jbregnard/vesta/README.md

# vesta
Software and hardware files for the Vesta project
