jbregnard/vesta/vesta_pcb_files/readme.md

Here can be found all the files related to the PCB.
