jbregnard/vesta/Rapports/vesta_latex_repport/chap/design.tex

\section{Industrial design}

In this section, the industrial design will presented. The design part was done by the ECAL student. The indutrial designer presented different solutions, they were then discussed together with the other member of the group. The solutions were also presented to the nurses and some old people to define which one is the more understandable and easy to use.

\subsection{Tablet}
The device has a unique aspect. It has round shapes and is elegant.
The color of the case is warm and positive. It also is a visible color and not agressive. The screen size is 7 inches with a resolution of 800x480. It is big enough to display readable messages and images.

The case has a certain thickness to allow the users to have a better grip. The device can have 2 postures, vertical or horizontal. The user can then watch the tablet sitting down and holding it in his hands or the device can be used like a digital photo frame.
When the device is on the charging station it is in the vertical position.

The design of the tablet is shown in the figure \ref{fig:vesta design}.

\begin{figure}[!htb]
    \centering
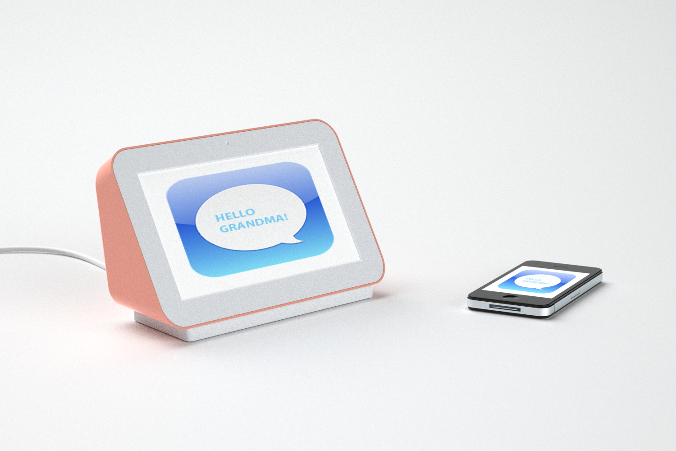
[picture p1: Rapports/vesta_latex_repport/chap/designFig/VestaRender4.png]
    
    \caption{Vesta tablet design}
    \label{fig:vesta design}
\end{figure}

On the left, the vesta tablet on the charging station. On the right, an iphone for scale.

\subsection{Charging station}
The charging station is quite descrete, takes up little space and is very nice. It can be placed anywher without having to hide it.It is wireless. More and more devices in the market allow to charge the battery wirelessly. To charge the tablet's battery, the tablet need to be located on the charging station. The advantage of this station is that the users don't need to plug a small cable like micro USB into the tablet to charge it. The charging station method is much easier to use.

\begin{sidewaysfigure}[!htb]
    \centering
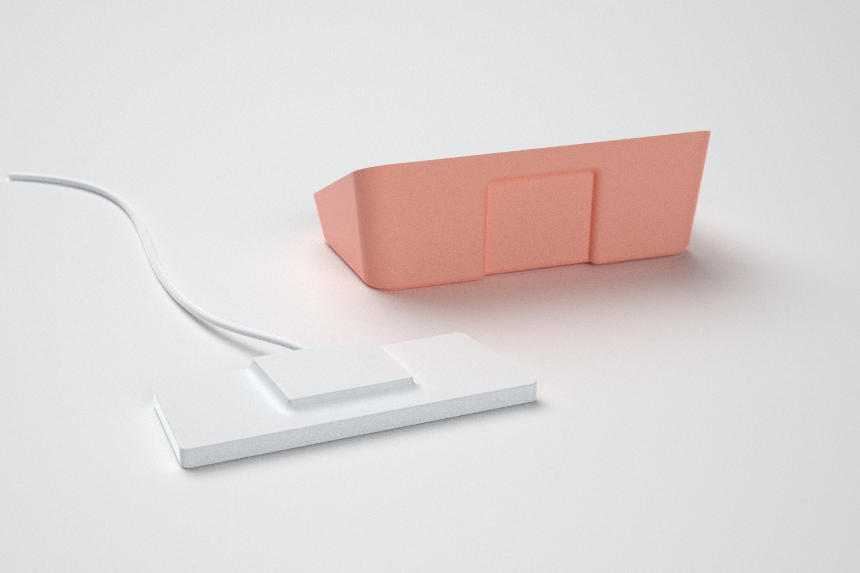
[picture p2: Rapports/vesta_latex_repport/chap/designFig/VisioRender7.png]
    
    \caption{Charging station}
    \label{fig:charging station}
\end{sidewaysfigure}

On the left, the inductive charging station. On the right, the vesta tablet in horizontal position.

\clearpage

\subsection{Software design}

The software located on the tablet needs to be very easy to use and understandable by an old person. Different designs were imagined, tested and compared.

The graphical interface of the software is shown in the figure \ref{fig:soft design}.

\begin{figure}[!htb]
    \centering
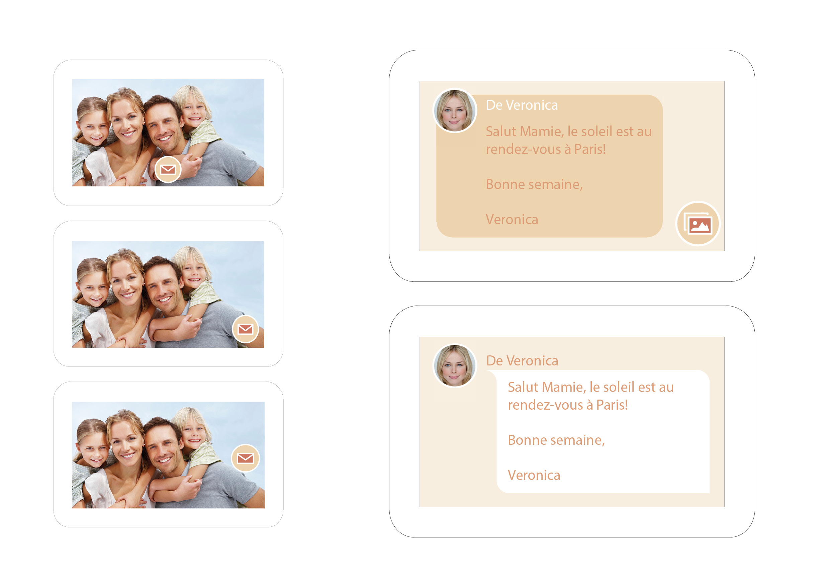
[picture p3: Rapports/vesta_latex_repport/chap/designFig/vesta_design.jpg]
    
    \caption{Software design}
    \label{fig:soft design}
\end{figure}

On the left the software design imagined for the picture display with the button to display the text message. And on the right, the design of the text message display with the picture of the sender and the button to return to the picture.
\subsection{Visual identity}
The visual identity keeps the same tone of colours as the casing of the device. A name a logo and a style were sought for.

In figure \ref{fig:id seek} different logos can be seen.
\begin{figure}[!htb]
    \centering
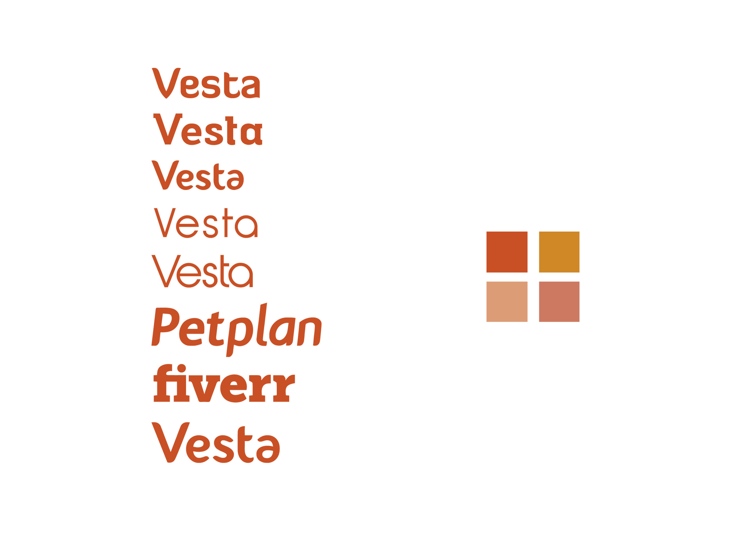
[picture p4: Rapports/vesta_latex_repport/chap/designFig/VestaRechercheIdentity3.jpg]
    
    \caption{Search for a visual identity}
    \label{fig:id seek}
\end{figure}

In figure \ref{fig:id seek icon} different icons where imagined and evaluated.

\begin{figure}[!htb]
    \centering
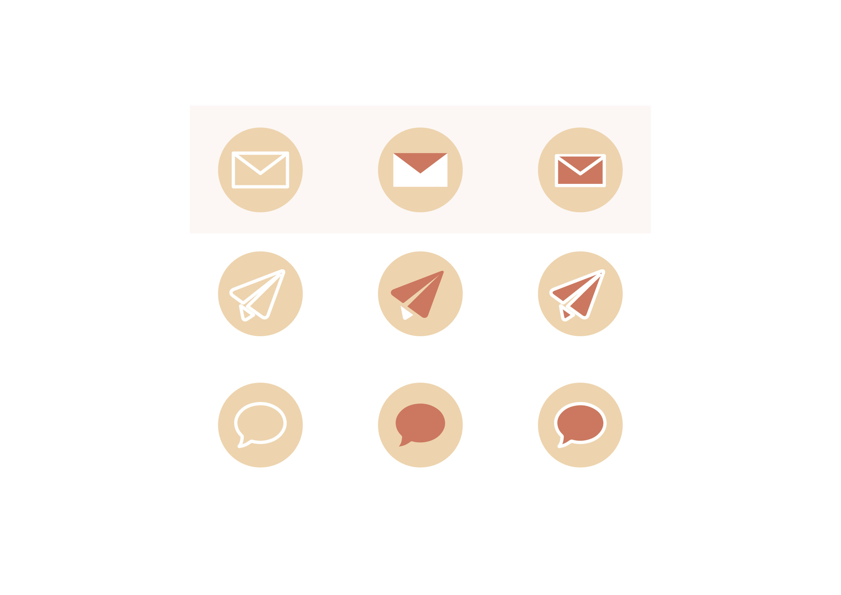
[picture p5: Rapports/vesta_latex_repport/chap/designFig/VestaRechercheIdentity5.jpg]
    
    \caption{Search for a visual identity specific to icons}
    \label{fig:id seek icon}
\end{figure}
