jbregnard/vesta/Rapports/vesta_latex_repport/chap/software.tex

\definecolor{gray}{rgb}{0.4,0.4,0.4}
\definecolor{darkblue}{rgb}{0.0,0.0,0.6}
\definecolor{cyan}{rgb}{0.0,0.6,0.6}

\section{Software}
%\subsection{Description}
The software of this project contains 3 parts:
\begin{itemize}
\item{The operating system configuration and modification to be fully compatible with the hardware used.}
\item{The website that is used by the young users to send pictures and messages to the old users.}
\item{The Vesta tab software that is used on the tablet to display the differents messages and pictures received by the old users.}
\end{itemize}

The concept of this software is easy to understand. Every tablet has a unique id like a phone number. The young user knows this id and can send messages and pictures to the wanted tablet through the website. The tablet just needs to be configured to connect to the wifi and get messages sent by the young user. The old person has almost nothing to do, the pictures are displayed automatically. He can naviguate in the old messages by swiping the pictures on the tablet.

It is similar to a digital photo frame but the pictures are not put on the tablet by the tablet owner but by the young user.

The figure \ref{fig:web connections} shows the web interactions between the website and the Vesta software on the tablet.

\begin{figure}[!htb]
    \centering
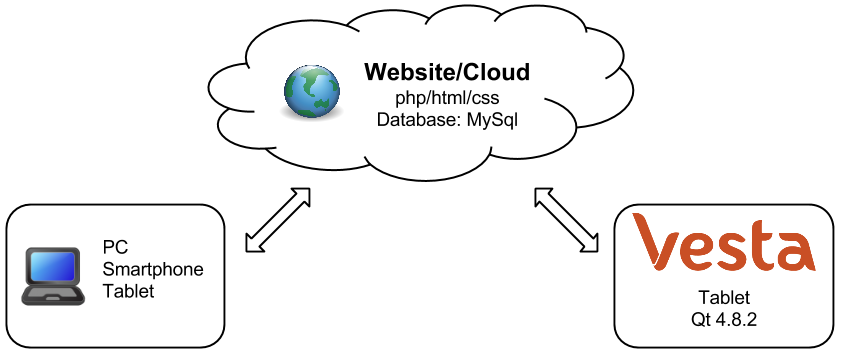
[picture p27: Rapports/vesta_latex_repport/chap/softFig/web_connections.png]
    
    \caption{Web connections}
    \label{fig:web connections}
\end{figure}

\clearpage

The figure \ref{fig:user flow} shows the interactions between the website and the Vesta software on the tablet. All the files are stored on the website on the mySQL database. When the pictures are sent, the vesta tablet receives a message and can open/display it. The vesta software on the tablet works on a linux OS that manages the hardware.

\begin{figure}[!htb]
    \centering
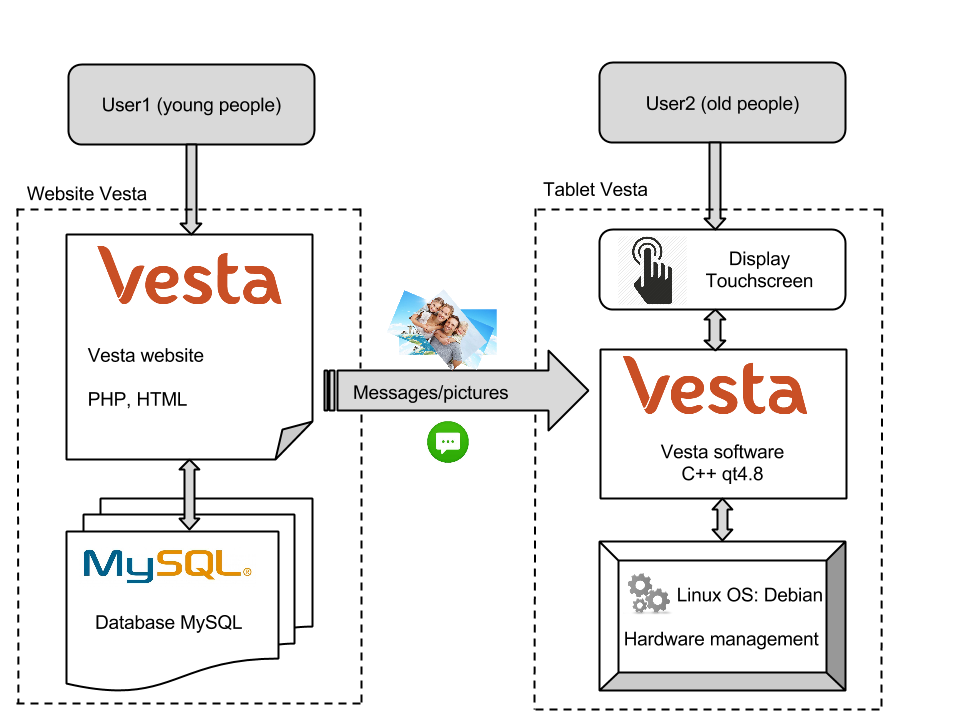
[picture p28: Rapports/vesta_latex_repport/chap/softFig/block_diagram_vesta2.png]
    
    \caption{Basic user flow.}
    \label{fig:user flow}
\end{figure}

\clearpage

\subsection{Operating system}
The OS used for this project is a debian. Debian is a linux distribution and was given by the conceptors of the beaglebone black.

The original OS is available on the beaglebone black developer website: http://beagleboard.org/latest-images

The figure \ref{fig:OS} shows how the are the interactions between the OS and the hardware or the software.

\begin{figure}[!htb]
    \centering
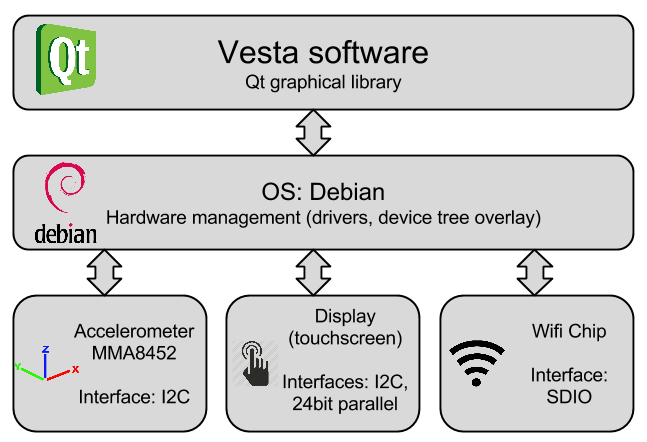
[picture p29: Rapports/vesta_latex_repport/chap/softFig/first_diagram2.png]
    
    \caption{Interactions between the operating system and the hardware/software.}
    \label{fig:OS}
\end{figure}

The original OS contains:
\begin{itemize}
\item{kernel 3.8: The linux kernel (an old one)}
\item{X11: The graphical server}
\item{lxdm: The user session management}
\item{lxde: A desktop (light)}
\end{itemize}

The OS manages the communications with the different hardware. The accelerometer is controled by I2C (to read datas and write configurations). The screen uses different interfaces, I2C for the touch panel and 24bit parallel for the display. The WIFI chip is connected with SDIO and it replaces the emmc memory.

Every protocol and every pins input or output have to be declared in a file called device tree source. In the 3.14 kernel, this file is compiled and becomes a device tree blob. The compiled version of the file is executed at the OS startup. It initiates the loading of the drivers and configures the pins as input, output, pwm or interrupt. Some pins can be configured as i2c, spi, SDIO or some other protocols.

Packets installed on the original debian OS:
\begin{itemize}
\item{libqt4-core: Defaults tools for Qt software execution}
\item{libqt4-gui: Needed to display GUI software developped with Qt}
\item{dtc: Device tree compiler used to create pin configuration at the OS startup}
\item{wicd: Network manager for WIFI connections}
\item{evtest: Tool for interruption event, used especially to debug the touchscreen}
\end{itemize}

\subsubsection{Drivers}
A lot of work on this linux distribution was made to be fully compatible with the chosen hardware.
The touch screen driver edt-ft5x06 had problems with the original 3.8 kernel of the distribution used. The driver was not loading correctly from the device tree overlay. An upgrade to the 3.14 kernel resolved the problem.
Then the scale of the touchscreen was not correct.
When a touch event occured on the right-down corner, the mouse pointer moved to the center of the screen. Some configuration scripts had to be modified for the X11 graphical display server.

The edt-ft5x06 uses an interrupt line and I2C to get the touch events and the positions of the clicks.

Another driver is used for the WIFI connection with the wl1835mod. This driver uses the protocol SDIO. It also has to be declared and initialized at the OS startup in the device tree blob. As the beaglebone's processor has only one SDIO protocol possible and it is used by the emmc memory, the emmc is replaced by the WIFI chip and the emmc is unusable.

An example of the configuration of the I2C1 of the beaglebone black as an entry for the touch panel (driver edt-ft5x06) in the device tree source (dts) is shown in the listing below.

\begin{lstlisting}
i2c@4802a000 {
	compatible = "ti,omap4-i2c";
	ti,hwmods = "i2c2";
	reg = <0x4802a000 0x1000>;
	interrupts = <0x47>;
	status = "okay";
	pinctrl-names = "default";
	pinctrl-0 = <0x29>;
	clock-frequency = <0x61a80>;

	edt-ft5306@38 {
		status = "okay";
		compatible = "edt,edt-ft5306", "edt,edt-ft5x06";
		pinctrl-names = "default";
		pinctrl-0 = <0x2a>;
		reg = <0x38>;
		interrupt-parent = <0x1c0>;
		interrupts = <0x15 0x0>;
		touchscreen-size-x = <0x320>;
		touchscreen-size-y = <0x1e0>;
	};
};
\end{lstlisting}

i2c@4802a000 corresponds to the I2C1 of the beaglebone black (even if it defines I2C2 in ti,hwmods, this is due to a problem in the kernel 3.14 the pins are not named correctly). The following commands init the I2C1 at the clock frequency 0x61a80. The line starting with edt-ft5306@38 declare that the driver edt-ft5x06 has to be link to the I2C1 and the I2C adress is 0x38. Different inputs are declared in the brackets, the interrupt-parent and interrupts defines the interrupt line when a touch event occurs. Reg is the I2C adress of the Focaltech chip (ft5x06). The pin <0x1c0 0x15 0x0> corresponds to the pin 25 of the beaglebone black. The touchscreen size is also given: 800*480 (0x320*0x1e0).

\clearpage

\subsubsection{Display}
The touch screen works with a 24 bits parallel interface so the X11 configuration file had to be modified to work correctly. The LCD output was initialy configured in 16 bits parallel interface.
In the blob file, the driver for the touch panel was declared and the interrupt pins was defined. The resolution and frequency of the display is also configured in this script. The wifi chip also needs to load drivers at startup and tell the OS to connect to internet via this chip and with the SDIO protocol.
The file is located in /boot/dtbs/3.14xx/ and is called vesta.dtb (compiled) and the source is called vesta.dts. The file uEnv.txt located in /boot/ also needs to define which device tree blob(dtb) the OS has to load at startup.

The following listing shows how to define the display output on the pins of the beaglebone black. It is a critical step and need to be declared like this.
\begin{lstlisting}
display-timings {
	native-mode = <0x1c5>;

	800x480 {
		clock-frequency = <0x1c9c380>;
		hactive = <0x320>;
		vactive = <0x1e0>;
		hfront-porch = <0x1>;
		hback-porch = <0x2d>;
		hsync-len = <0x1e>;
		vback-porch = <0x16>;
		vfront-porch = <0xc>;
		vsync-len = <0x2>;
		hsync-active = <0x1>;
		vsync-active = <0x1>;
		de-active = <0x1>;
		pixelclk-active = <0x0>;
		linux,phandle = <0x1c9>;
		phandle = <0x1c9>;
	};
};
\end{lstlisting}

The native-mode defines that it is a 16/9 screen. The clock frequency is 30MHz and the resolution 800x480. hactive and vactive define respectively the horizontal number of active pixel and the vertical number of pixel active (in our case 800x480). Other configuration modes are defined then. For more informations about the configurations, check the Newheaven touchscreen's datasheet.

\clearpage

\subsection{Website}

The website is used by the young users to send messages and pictures to the old user’s tablet.
The website contains a MySQL database, a php/html page that let the young user send a message and a php script used to parse the database to XML to be readable by the tablet.

The figure \ref{fig:web archi} shows the architecture of the interactions between the webpage, the database and the connections by the tablet through a script.

\begin{figure}[!htb]
    \centering
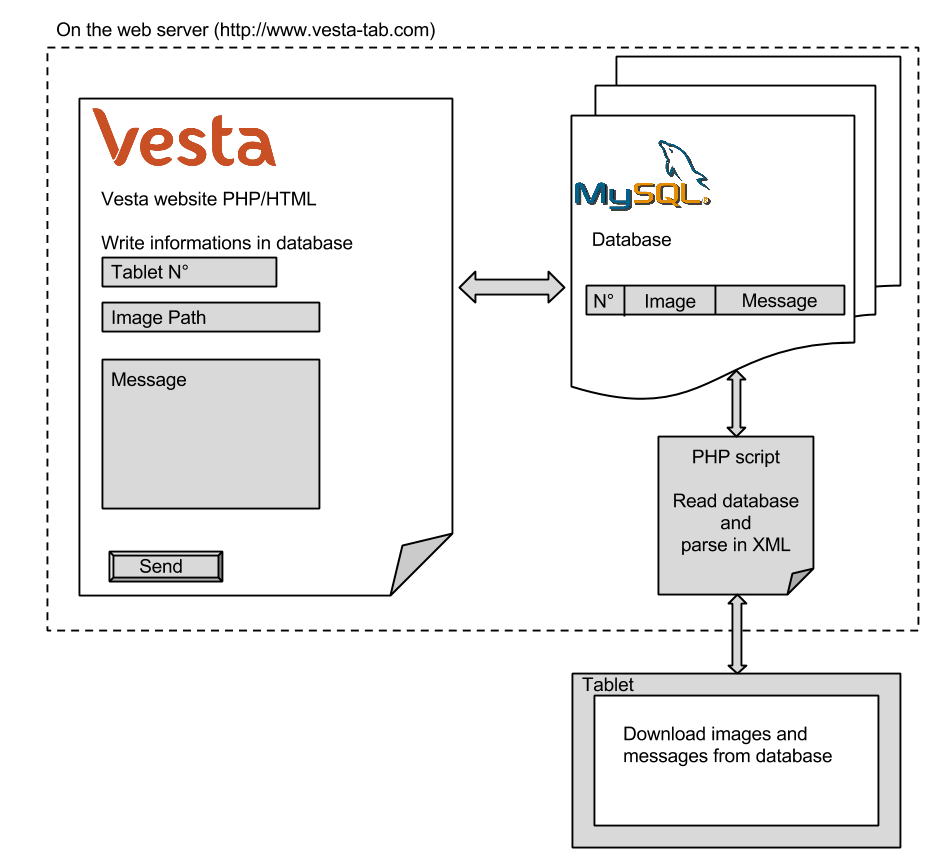
[picture p30: Rapports/vesta_latex_repport/chap/softFig/vesta_website2.png]
    
    \caption{Vesta website architecture.}
    \label{fig:web archi}
\end{figure}

The steps of the vesta tablet connecting to the database are:
\begin{enumerate}
\item{The tablet connects to a php script}
\item{The php script open a connection with the MySQL database and get the datas wanted}
\item{The php script parse the datas in XML, and sends it}
\item{The tablet get the XML code and unparse it}
\item{The tablet displays the messages and pictures}
\end{enumerate}

The website connects directly to the database to store the input picture and messages.

\clearpage

\subsubsection{Webpage}
The webpage let the young user send a message to a wanted tablet. Every tablet has an id like a phone number known by the tablet owner. It is possible to select a picture on the user's computer and write a text message. When the "send" button is clicked, the picture and text message is saved in the MySQL database.

The php script called when the send button is clicked downloads the picture contained in the file input, verify if the file downloaded is a picture and if the size is not too big. If everything went well the picture and the other datas are saved in the MySQL database else some error messages are displayed. The date is automatically written at the current time.

The figure \ref{fig:webpage} shows the actual webpage used to send messages to a tablet.
\begin{figure}[!htb]
    \centering
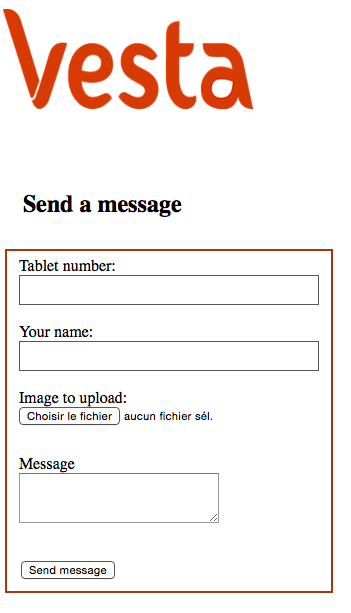
[picture p31: Rapports/vesta_latex_repport/chap/softFig/web_front_page.png]
    
    \caption{Webpage}
    \label{fig:webpage}
\end{figure}

This webpage is not finished but is fonctionnal. For security and privacy reason, a login and session creation page should be done to prevent people sending to the wrong tablet. A blocking system needs to be implemented if someone sends adverts or inapropriate messages.

\clearpage

\subsubsection{Database and XML parsing}
The MySQL database is where all the messages and pictures are stored. The webpage connects and save the datas into the database when the user send a message.

An example of entries on the tablet's MySQL database are shown in the table\ref{tab:database}.

\begin{table}[!htb]
\begin{tabular}{|c|c|c|c|c|c|c|}
  \hline
  id & type & name & sender & text & img & date \\
  \hline
  7 & image/jpeg & family.jpg & Jean & Hello! A message for you & BLOB - 300KB & 14.05.2015\\
  8 & image/jpeg & cat.jpg & Marie & Look at my cat :) & BLOB - 350KB & 27.05.2015\\
  \hline
\end{tabular}
\caption {Example of entries in the vesta table on the MySQL database}\label{tab:database}
\end{table}

BLOB is the file format of the pictures stored in the database.

When the tablet update the data, it connects to a script contained on the server. This script connects to the database and parses the information needed by the tablet in XML.The tablet then unparses the data, downloads the pictures, and displays them.

XML is a markup language that facilitates the transfer of data and the readability of them. It is mainly used in the RSS flux.

An example of XML code is shown below:

\lstset{
 style=customXML,
 basicstyle=\ttfamily,
 columns=fullflexible,
 showstringspaces=false
}
\begin{lstlisting}
<?xml version="1.0"?>
<vesta>
  <item>
    <title>family.jpg</title>
    <sender>Jean</sender>
    <date>2015-04-18 17:08:45</date>
    <image>http://www.vesta-tab.com/jo/getImage.php?id=7</image>
    <message>Hello! A message for you</message>
  </item>
  <item>
    <title>cat.jpg</title>
    <sender>Marie</sender>
    <date>2015-04-23 14:34:12</date>
    <image>http://www.vesta-tab.com/jo/getImage.php?id=8</image>
    <message>Look at my cat</message>
  </item>
</vesta>
\end{lstlisting}

This XML file defines 2 messages: family.jpg and cat.jpg. The senders are Jean and Marie at respectively 17:08:45 the 18th april 2015 and 14:34:12 the 23th april 2015. The images are available at the URL defined between the image markups. The text message is between the message markups.

\clearpage

\subsection{Vesta software on the tablet}
The Vesta software is used by the old users to receive and display the messages and pictures sent by the young users. It is located on the tablet and working with debian. The software is written in C++ with Qt4.8/Qt quick 1.0.

\subsubsection{Qt library}
Qt is a free library used mainly to design software with graphical user interfaces (GUI). It is cross platform so with the same code it is possible to compile for linux,windows and mac.
The library contains also a lot of utils to facilitate the development of emmbedded interfaces and manages the touchscreen events like swipes, clicks and more. A lot of documentation is available and a lot of users develop with it.

There are differents GUI library like Gtk+, CEGUI etc... The choice of Qt was done especially because it is cross platform but also because it's compatible with emmbedded systems. Qt can be used also with android and IOS and is really made for apps with touchscreen. Qt quick is very powerful for emmbedded applications. The last version of Qt was downloaded over 1 million times and is ranked number 1 of all cross-platform tools.

Qt creator is the official development environnment for Qt. It is used to develop and cross-compile the software for the beaglebone black. A visual GUI editor is available and greatly simplify the development of the software GUI.

\clearpage

\subsubsection{Overall operations}
At the startup, the vesta tablet inits and checks the wifi connection. The touchscreen creates an event when someone touches it and changes the displayed image. It lets the user naviguate between the different messages. Every minute the soft checks if a new message has arrived.

The software is quite simple and not a lot of functionnalities are implemented. The goal was to have a really easy to use software for old people.

The figure \ref{fig:soft archi} shows how the software works.

\begin{figure}[!htb]
    \centering
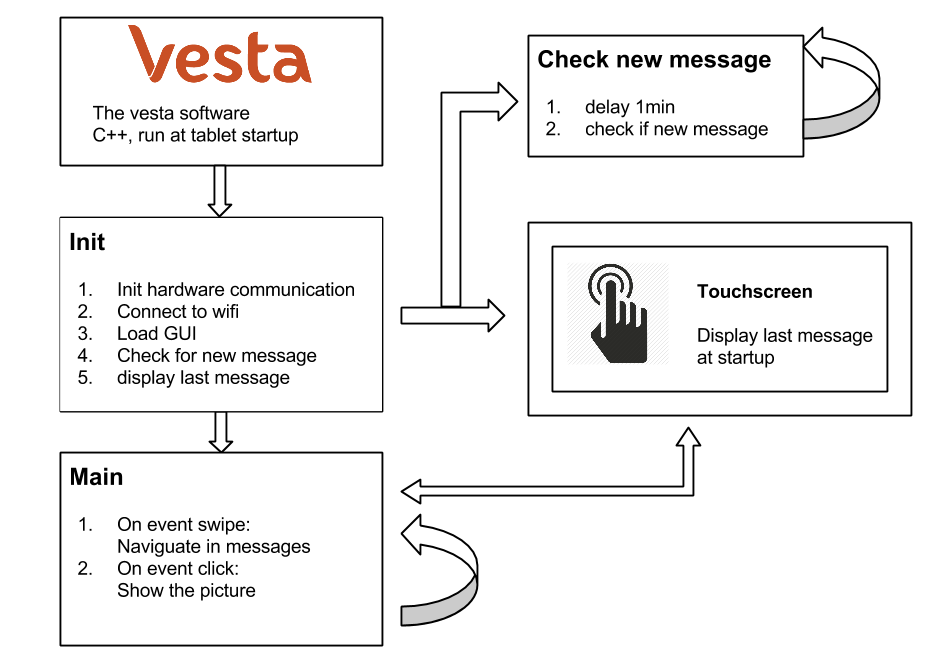
[picture p32: Rapports/vesta_latex_repport/chap/softFig/vesta_software_diagram2.png]
    
    \caption{Vesta software architecture.}
    \label{fig:soft archi}
\end{figure}

\clearpage

\subsubsection{Graphical interface}
The graphical interface is composed of an horizontal listview and some buttons. The listview allows swipe events to naviguate between the different pictures and messages.

A task bar is always visible on the top of the GUI. The list view displays the actual picture, the date when the messages was sent and the text message.

The figure \ref{fig:gui diagram} shows how the GUI is constructed.

\begin{figure}[!htb]
    \centering
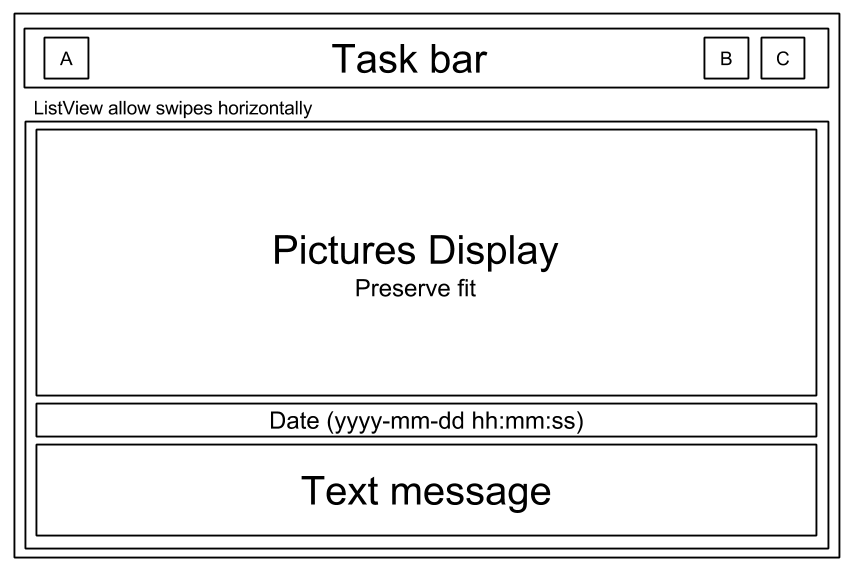
[picture p33: Rapports/vesta_latex_repport/chap/softFig/GUI_diagram.png]
    
    \caption{Graphical interface diagram, A:Refresh button, B:WIFI RSSI indicator, C:Battery state indicator}
    \label{fig:gui diagram}
\end{figure}

The buttons let the user configure the wifi or display the new messages.

\begin{itemize}
\item{The button A refresh the messages and display the last one.}
\item{The button B goes to the WIFI configuration and indicates the RSSI of the WIFI.}
\item{The indicator C show the battery level}
\end{itemize}

The figure \ref{fig:graphical interface} shows the actual GUI.

\begin{figure}[!htb]
    \centering
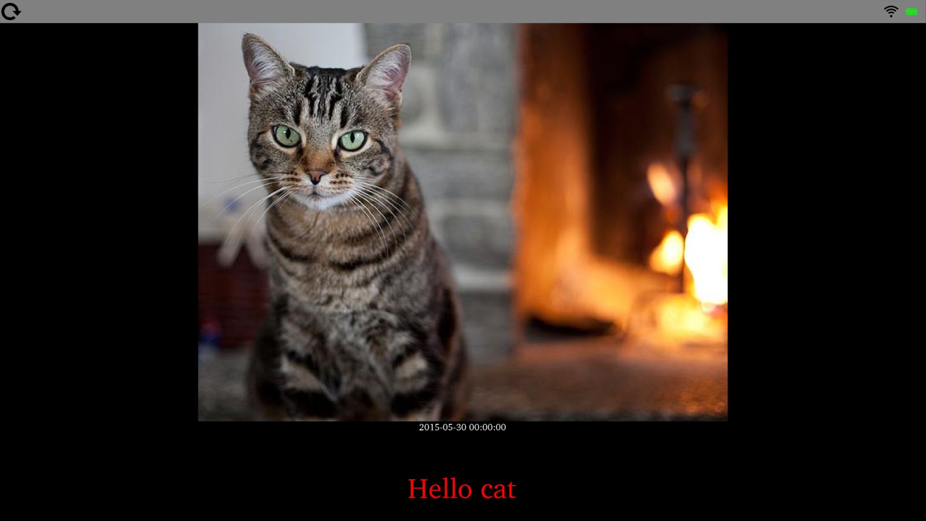
[picture p34: Rapports/vesta_latex_repport/chap/softFig/vesta_printscreen.png]
    
    \caption{Vesta software graphical interface}
    \label{fig:graphical interface}
\end{figure}
