jbregnard/vesta/Rapports/vesta_latex_repport/Rapport.pdf

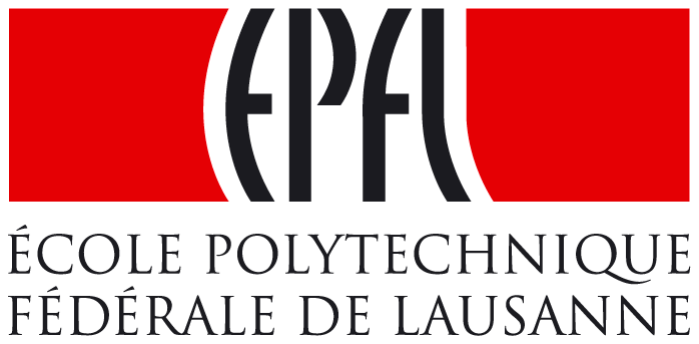
[picture p35: figure]

MT MA1 - Semester project

# China Hardware Innovation Camp - Vesta

## Engineering Report

Jonathan Bregnard,
Igor Ayrton

juin 2015

Responsables:
Prof. M. Bouri

## Table des mati`eres

### 1 Introduction

1

### 2 Problem and Solution

2
2.1 Problem

2
2.1.1 Younger generation needs

2
2.1.2 Elderly needs

2
2.2 Solution
3
2.3 Vesta tab

3

### 3 Value Proposition and Buisness Model

4
3.1 Value Proposition

4
3.2 Buisness model

4
3.3 User tests

4

### 4 Industrial design

5

### 5 Materials

6

### 6 Hardware

7
6.1 Beaglebone Black

7
6.2 Screen and Touchscreen | 10
6.2.1 Screen | 10
6.2.2 Touchscreen | 10
6.2.3 Backlight | 10
6.3 Wireless Communication | 11
6.3.1 Wlan | 12
6.3.2 Bluetooth | 13
6.3.3 Power management | 13
6.3.4 Buffering | 13
6.3.5 Antennas | 13
6.4 Front LED | 14
6.5 Power management | 14
6.6 Batteries and charger | 14
6.7 PCB | 14
6.7.1 Overall description | 15
6.7.2 Antennas | 15
6.8 Cost estimates | 16
7 Software | 17
7.1 Operating system | 17
7.1.1 Drivers | 18
7.1.2 Display | 19
7.2 Website | 19
7.2.1 Webpage | 20
7.2.2 Database and XML parsing | 20
7.3 Vesta software on the tablet | 21
7.3.1 Qt library | 21
7.3.2 Overall operations | 21
7.3.3 Graphical interface | 22
8 Next steps | 24
9 Problems encountered | 24
10 Conclusion | 25 i

1 INTRODUCTION

## 1 Introduction

This semester project takes part of the CHIC2015 which is a new project initiated at EPFL by Marc Laperrouza. The goal of this new project is for students develop a project from idea to production in a semester. Indeed a trip to Shenzhen in China is programmed following the end of the semester(july). We are heading to a prototyping facility ther called Seeedstudio. They mainly do pcb prototyping but they also mill and 3d print parts.

Three groups of 5 people are created after a brainstorming week-end at the beggining of the semester with for each group one HEC (economy) student, one ECAL (industrial design) student and three engineering students from EPFL. For the project presented in this report, two engineers are from microengineering and one is from material science.

After the brainstorming week-end, the rough idea was to connect elderly people to their families with an easy to use electronic device.

J. Bregnard, I. Ayrton | 1

2 PROBLEM AND SOLUTION

## 2 Problem and Solution

In this section we will lay out the problematic we wanted to adress during this project. Our chosen solution will be introduced and described.

### 2.1 Problem

The first part of the project was to define what are the needs of the elderly and their families in term of connectivity.

More and more people are connected to social networks and use internet to communicate. They share pictures or videos, send messages with their smartphones, tablet or PC. A lot of people who followed these new technilogies use it everyday with friends or family. A big part of the population is excluded as they are not able to use these new technologies. The goal is not to teach the old people how to use a computer or a smartphone but to have a device that would let them keep connected and included in the numerical world.

Especially in occidental countries, when the elderly are not able to take care of themself, they are going to an old people’s home. Most of them would prefer to stay home longer. A device that would keep the old people connected with their family, check if everything is alright, make health tests could let the old people stay longer at their place.

### 2.1.1 Younger generation needs

To determine what are the young people needs, a quiz(survey) was put on internet to ask how young people would like to discuss with their grand parents. The quiz contained questions of the type :
- How often do you discuss with your grand parents ?
- What is the best way to do it ? Social network, phone call, sms, visit them. . .

Most of them wanted to have more contacts with their elders but not through available social networks (facebook, twitter, instagram, google+). This was mainly due to the elderly beeing unfamiliar with these means of communication. They mainly wanted to be able to share text and photos. Some of them would have liked to be able to make video calls.

### 2.1.2 Elderly needs

To define the needs of the elderly, a visit in an old peoples home (EMS) was organised and some questions about what they want and what they are able to do were asked to them and also some technical questions were asked to the nurses.

The general feeling is that the elderly generation is left out of the new technological world and developpment rarely take their input into consideration.

The questions to the nurses were more about the facilities old people have with new technologies. The results that came out of the discussion was that the old people don’t ear well sounds and are not able to define where the song is coming so putting an alarm on the device wouldn’t be a good idea. The interface has to be as simple as possible because they are lost if there are too many options. The device has to be big enough and shouldn’t break after a shock. The text on the device has to be big enough to be read by old people.

2 | J. Bregnard, I. Ayrton

2 PROBLEM AND SOLUTION

### 2.2 Solution

As the majority of the content people wanted to send to each other was text and images, the device at least needs a screen and some kind of user interface. The challenge and purpose of the project was to find a user interface adapted to the elderly. The younger generation could use the internet on any device already available. Different solutions were imagined. A device that connects to the TV with HDMI and display pictures, messages and videos on it.

A device that connects to the web with a 3G chip (don’t need the wifi and is more portable) or a device that contains only a wifi chip.

A device with a touch screen or only a screen. With physical buttons or not.

From the visit to the EMS we found out that :
- it was best if the device was portable.
- A 7 inch screen was big enough
- A flat device such as existing tablets was not suitable as it could get easily lost under things and the grip was not easy.
- The color of the object is important as elderly tend to have many things and the device should be easily localisable
- Sound was not a good medium to emit notification, visual stimulis was better.
From these elements we decided to build a portable communication device dedicated to the elderly. This device has a 7 inch touchscreen has wifi and bluetooth capabiities a battery and a no contact charging station. In parallel to this device a website and an app dedicated to the families of the elderly are linked to the device.

The families have an account wich is linked to a or several individual devices. The website and the app then allow the families to send photos and/or text directly to the connected device(s). As soon as the device receives a new message a small LED starts to blink. When the elderly person opens the new message simply by touching the screen this triggers and automatic acknowledgment message to the sender.

The website also allows to adjust certain settings of the device such as screen brightness, in which order are the messages displayed, or the size of the text of the messages. The goal is to have the younger generation deal with all the setting up which might need a little more technological knowledge. The elderly can then relax and not think about anything outside the main purpose of the device.

### 2.3 Vesta tab

image rendu vesta

The Vesta tab is a tablet oriented towards the elderly. It has a capacitive touch screen, a wifi and bluetooth connection and a unique casing. The main usage at the moment is receiving and displaying pictures and text sent by the younger family via the dedicated website. As soon as a new image or text is received an LED blinks to inform the user of new content. The interface is designed to be very user friendly and easy to use.

J. Bregnard, I. Ayrton | 3

3 VALUE PROPOSITION AND BUISNESS MODEL

## 3 Value Proposition and Buisness Model

### 3.1 Value Proposition

### 3.2 Buisness model

### 3.3 User tests

4 INDUSTRIAL DESIGN

## 4 Industrial design

The design part was done by the ECAL student.

The graphical interface of the software is shown in the figure 4.1.


Figure 4.1 – Software design

J. Bregnard, I. Ayrton | 5

5 MATERIALS

## 5 Materials

6 HARDWARE

## 6 Hardware

This section is dedicated to show all the electronic components we chose and how they work together. As described earlier the PCB containing all the components will be manufactured by Seeedstudio. They manufacture PCBs with other hardware components and they sell quite a number of different breakout boards and other developpement parts. A request made by CHIC managing team was to source as many components as possible at Seeedstudio. Of course not all components we needed were available by them so some of the components are from different sources.

We were basically going to build a tablet. It didn’t need to have the power of high end tablets of today but it still was quite a challenge. At first we were thinking it would be possible to take an open source ARM chip devellopment board, devellop our application and then take the schematics and rebuild a whole board including the processor, memory, etc.. plus all our peripherals and build the whole device from scratch. But we quickly understood that it was much too complicated to do in a semester. So we decided to take an existing board and build an add-on board hosting our additionnal components.

There are a number of different devellopment/tinkering boards out there. The most famous one might be the raspberry Pi, although quite capable it seemed a little limited for our application (clocked at 700 mhz for the raspberry pi 1). Another problem was that the raspberry pi is not completely open source. Indeed its schematics and gerber files are not available. At the beginning of the project thinking we might build the whole board up from scratch it was necessary for us to work with a totally open source platform which we could build upon.

So we looked into one of the other famous board : the beagle bone black. Which we will further refer to as the BBB. This board clocked at 1 GHz seemed quite capable. There was lots of documentation, a wide community, and especially it is completelly open source hardware and software. This is what we went for.

In fig.6.1 we describe the different components of our device and how the connect to each other.

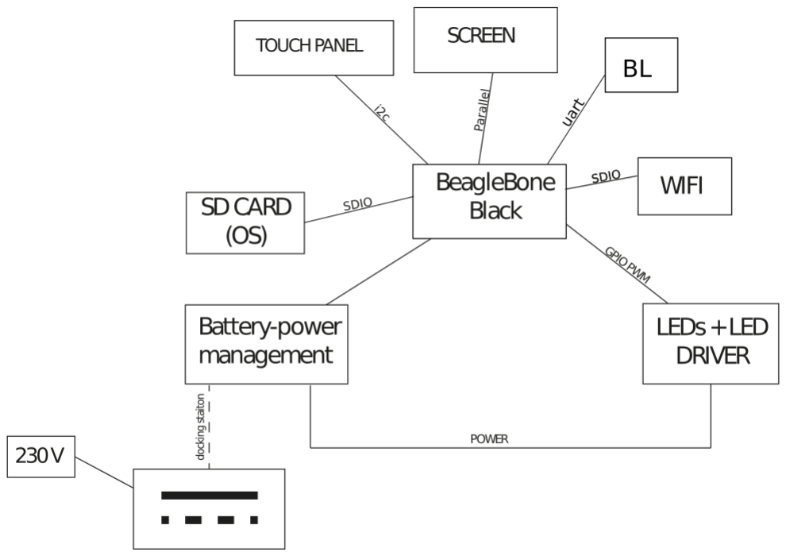
[picture p36: figure]

Figure 6.1 – Hardware components dependencies.

### 6.1 Beaglebone Black

The BBB uses an ARM processor from Texas Instruments, the AM335X. It is clocked at 1GHz.

J. Bregnard, I. Ayrton | 7

6 HARDWARE

- AM335x 1GHz ARM® Cortex-A8
- 512MB DDR3 RAM
- 4GB 8-bit eMMC on-board flash storage
- Ethernet
- 2x 46 pin headers
- Open source
The main interface of the BBB are the 92 pins. Many pins can be configured in different modes. The pins and modes are listed in fig.6.2.

6 HARDWARE

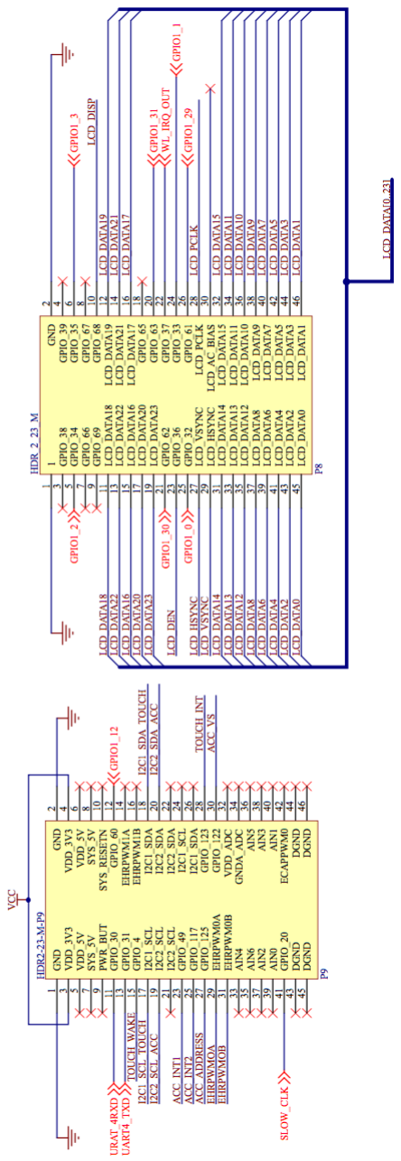
[picture p37: figure]

Figure 6.2 – Hardware components dependencies.

J. Bregnard, I. Ayrton | 9

6 HARDWARE

### 6.2 Screen and Touchscreen

At the current state of our prototype the main function is to view images and text. Therefore a good screen with realistic colors is necessary to have a good user experience. We first ordered a resistive touchscreen BBB cape (4DCAPE-70T by 4D systems) available from Seeedstudio to see how its was made and to see if the resistive technology was applicable to our project. We quickly realised that the resistive touchscreen was not very suitable to manipulate photos. Especially the very well known “swipe” geasture to move from one photo to another was impossible to do with the resistive touchscreen. This screens colors were coded on 16 bits and the viewing angle was quite bad. We decided to use a capacitive touchscreen and more colors if possible. We chose a screen we found on Mouser which had good documentation and especially there was an existing driver for the touchscreen IC in the linux kernel we were going to use. The screen is actually a package containing the screen and its driver, the touch-screen and its driver and the backlight LED array. This package can be seen in fig.6.3

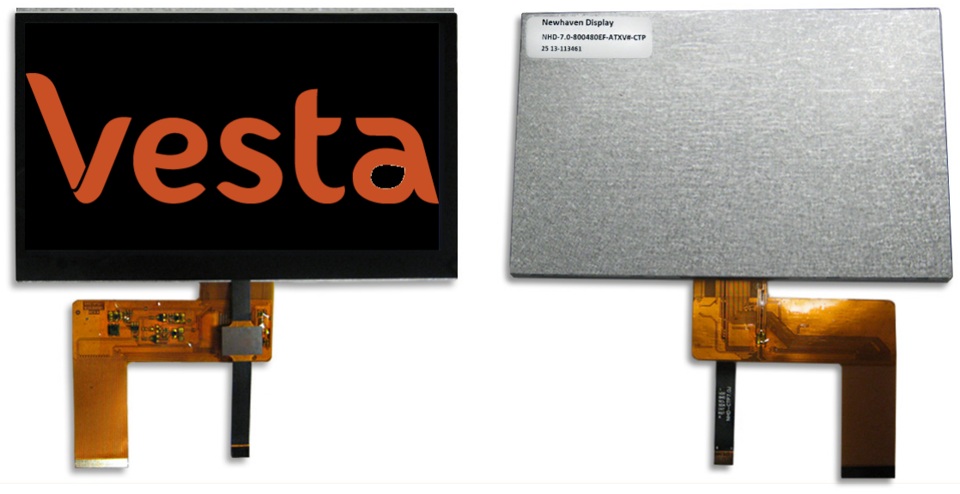
[picture p38: figure]

Figure 6.3 – Screen package.

Individual components are discribed in the following sub chapters.

### 6.2.1 Screen

The screen is the NHD-7.0-800480EF-ATXV#-CTP from Newhaven Display. The specifications of the screens are listed bellow.
- 7” Diagonal
- Resolution : 800xRGBx480
- 24 bit digital RGB interface
- White led backlight
- 55-65◦ Top-bottom viewing angle
- 70 ◦
left-rigth viewing angle

### 6.2.2 Touchscreen

- Capacitive touch panel with built-in Focaltech ft5x06 controller
- i2c interface
- linux kernel compatible

The touchpanel is very smooth and reactive. The

### 6.2.3 Backlight

The backlight is a quite bright white led array consisting of 5x3 LEDs. the configuration can be seen in fig.6.4

6 HARDWARE

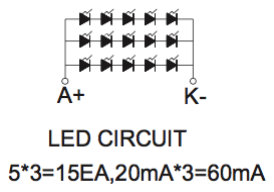
[picture p39: figure]

Figure 6.4 – Backlight LED array configuration.

This LED array requires 60 mA at 16 V to operate. This power is taken directly from the 3.3v of the BBB and boosted to the required voltage by FAN5333A LED driver from Fairchild semiconductors. This IC is a general purpose LED driver which can be controller with a PWM imput. Our implementation of the FAN5333B is pictured in fig.6.5.


Figure 6.5 – FAN5333B Backlight LED driver implementation.

From the data sheet the resistance R30 regulates the current. The net EHRPWMMOA is connected to a pwm pin on the BBB. The brightness of the screen will be adjustable from the website interface.

### 6.3 Wireless Communication

Our device has to connect to the internet over a WLAN to download new messages from the website. We chose to use the WL1835 chip from Texas instruments. This IC integrates WlAN, 4.1 bluetooth and BLE. An important point is that TI provides support for the linux kernel we are using and the AM335x 1GHz ARM® Cortex-A8.

The chip is provided in a 100-pin MOC package. The pin designation is seen in fig.6.6.

To operate the wl1835 needs a few external components. Among others an oscillator and antennas are necessary to for proper operation. The integration of this chip was inspired by a layout example provided by TI as well as by the layout of an existing BBB cape which can be found here http:

//boardzoo.com/index.php/beaglebone/beaglebone-wl1835mod-w-chip-antenna.html.

Our implementation is displayed in fig.6.7

J. Bregnard, I. Ayrton | 11

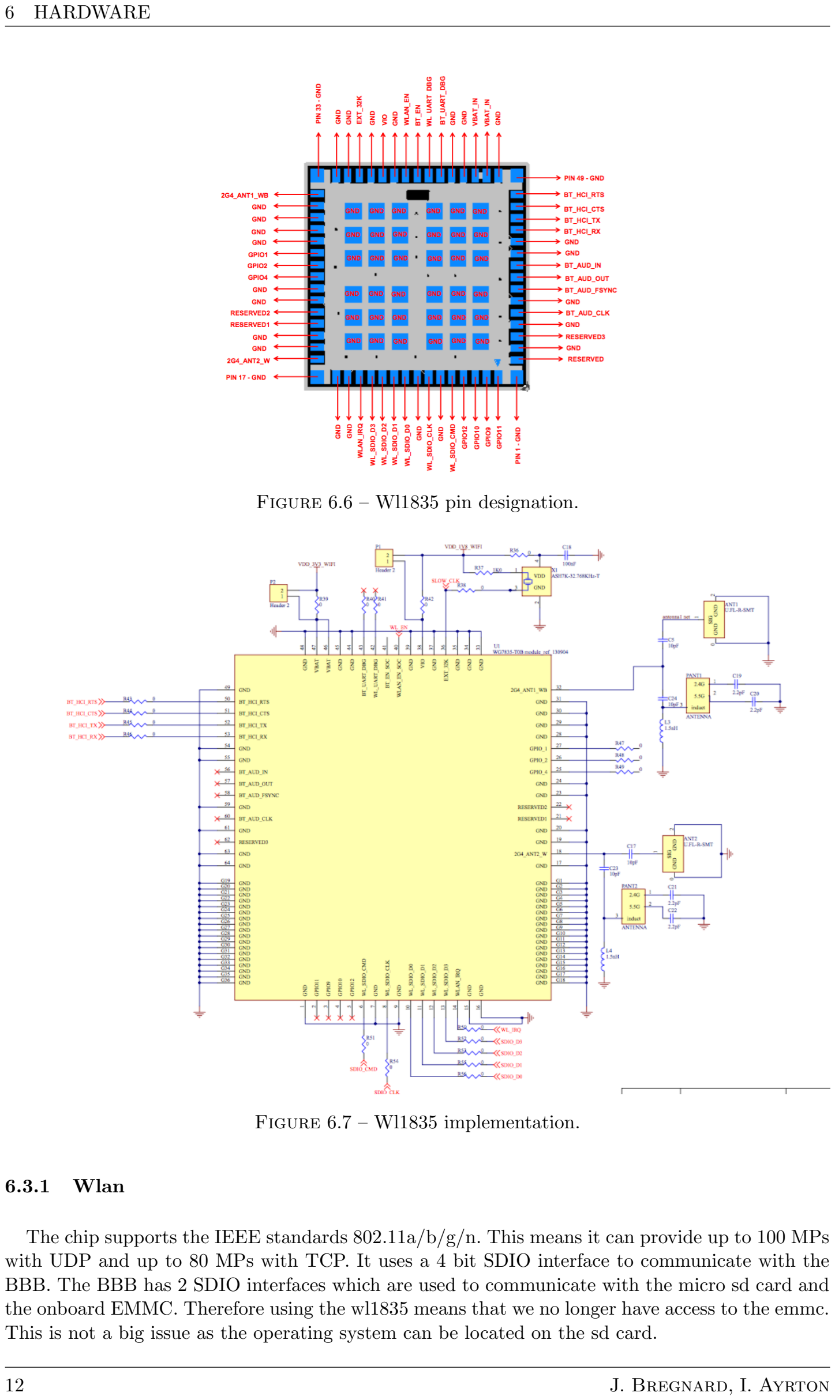
[picture p40: page 14]

6 HARDWARE

Figure 6.6 – Wl1835 pin designation.

Figure 6.7 – Wl1835 implementation.

### 6.3.1 Wlan

The chip supports the IEEE standards 802.11a/b/g/n. This means it can provide up to 100 MPs with UDP and up to 80 MPs with TCP. It uses a 4 bit SDIO interface to communicate with the BBB. The BBB has 2 SDIO interfaces which are used to communicate with the micro sd card and the onboard EMMC. Therefore using the wl1835 means that we no longer have access to the emmc. This is not a big issue as the operating system can be located on the sd card.

6 HARDWARE

### 6.3.2 Bluetooth

The Wl1835 provides 4.1 bluetooth and low energy bluetooth capabilities. Uart host controlled interface is used to communicate through this interface.

The bluetooth interface is not used currently. It is integrated thinking of future development (see chap.8).

### 6.3.3 Power management

The WL1835 is quite power hungry, it can pull up to about 500 mA of current and requires both 3.3V and 1.8V to operate. Therefore it has its own linear regulators which pull their current directly from the battery. For the 1.8V the TPS73618DBVR low voltage dropout regulator is used. It can output a maximum of 400 mA at 1.8V more


Figure 6.8 – Wl1835 power management implementation.

### 6.3.4 Buffering

As the signals that come in and out of the wl1835 are 1.6V and the BBB only works with 3.3V, we neeed to used a bidirectional Voltage-Level Translator. We chose the same ones which were implemented in the existing wl1835 cape(see). The TXS0108EPWR from TI.

The implemention of these voltage converters is displayed in fig.6.9.

### 6.3.5 Antennas

This chip can handle two antennas although only one is compulsory. Again following the TI design guide as well as the schematics of the wl1835 BBB cape mentioned in chap.6.3 we implemented a

J. Bregnard, I. Ayrton | 13

6 HARDWARE


Figure 6.9 – TXS0108EPWR buffering chip implementation.

dual antenna design. A ceramic chip was used as the ¨on board¨antennas. The layout and custom footprints designed for this part are further described in chap.6.7.

### 6.4 Front LED

The LED is there to inform the user of a new message. As it is only a notification LED a 20 mA LED is enough. The same FAN5333B driver for the led array in chap.6.2.3 is used. Another PWM pin of the BBB is used to make the LED blink.

### 6.5 Power management

The power source of the device is of course the battery. From the battery the power is channeled into two main groups. The wl1835 wireless chip and the The two main devices which draw the most current are the BBB and the wifi chip.

### 6.6 Batteries and charger

The battery is a 3.7V Lithium-ion battery with a capacity of 6000mAh from Seeedstudio. The voltage of such batteries range from 3.7V to 4.2V. Seeedstudio also sell a li-ion battery charger and wireless power trnasmission coils. We use this system

### 6.7 PCB

The PCB was designed in Altium Designer 15. Unfortunatly at this stage no prototype of the PCB has been made. All the components appart from the wl1835 have been tested with the BBB on a breadboard. The complex package of the chip prevents from connecting it to the BBB with wires. The cape mentionned in chap.6.3as source for the wl1835 implementation

6 HARDWARE

### 6.7.1 Overall description

The PCB is composed of four layers. These layers are described in table.1.

Layer name | type | Material | Thickness [mm]
Top Overlay | Overlay
Top solder | solder mask | surface material | 0.01
Component side | signal | copper
Dielectric 1 | Dielectric | FR-4 | 0.4
Ground | GND | copper
Dielectric 1 | Dielectric | FR-4 | 0.4
Power | VCC | copper
Dielectric 1 | Dielectric | FR-4 | 0.4
Bottom side | signal | copper

Table 1 – Pcb layer description

### 6.7.2 Antennas

The chip antennas are the ANT016008LCD2442MA1 from TDK. The datasheet and previously mentioned examples allowed us to design the custom footprint. The main considerations described by the afrtmentioned sources for the antennas to have maximum efficiency are :

- the antennas are orthogonal to each other
- They must be distanta of >76 mm which is a half wave length
- RF traces must have 50-Ωimpedance
- RF traces must not have sharp corners
- RF traces must have via stitching on the ground plane beside the RF trace on both sides
- RF traces must be as short as possible. The antenna, RF traces, and module must be on the edge of the PCB product in consideration of the product enclosure material and proximity


Figure 6.10 – Wl1835 pin designation.

J. Bregnard, I. Ayrton | 15

6 HARDWARE

### 6.8 Cost estimates

7 SOFTWARE

## 7 Software

The software of this project contains 3 parts :
- The operating system configuration and modification to be fully compatible with the hardware used.
- The website that is used by the young users to send pictures and messages to the old users.
- The Vesta tab software that is used on the tablet to display the differents messages and pictures received by the old users.
The concept of this software is easy to understand. Every tablet has a unique id like a phone number. The young user knows this id and can send messages and pictures to the wanted tablet through the website. The tablet just needs to be configured to connect to the wifi and get messages sent by the young user. The old people has almost nothing to do, the pictures are displayed automatically. He can naviguate in the old messages by swiping the pictures on the tablet.

It is similar to a digital photo frame but the pictures are not put on the tablet by the tablet owner but by the young user.

The figure 7.1 shows the web interactions between the website and the Vesta software on the tablet.

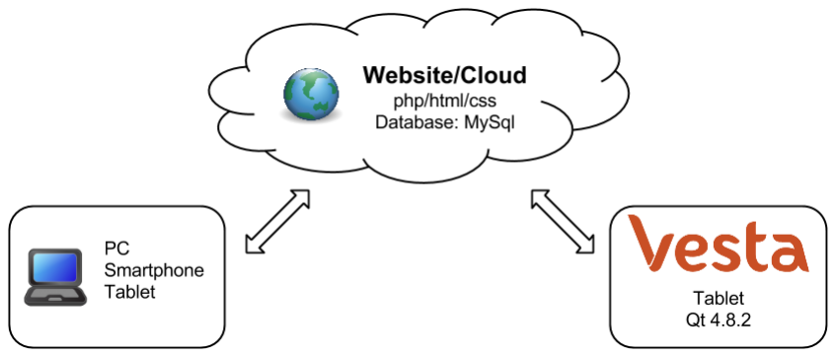
[picture p41: figure]

Figure 7.1 – Web connections

The figure 7.2 shows the interactions between the website and the Vesta software on the tablet. All the files are stored on the website on the mySql database. When the pictures are sent, the vesta tablet receives a message and can open/display it. The vesta software on the tablet works on a linux OS that manages the hardware.

### 7.1 Operating system

The OS used for this project is a debian. Debian is a linux distribution and was given by the conceptors of the beaglebone black.

The original OS is available on the beaglebone black developer website : http ://beagleboard.org/latestimages

The original OS contains :
- kernel 3.8 : The linux kernel (an old one)
- X11 : The graphical server
- lxdm : The user session management
- lxde : A desktop (light)
J. Bregnard, I. Ayrton | 17

7 SOFTWARE

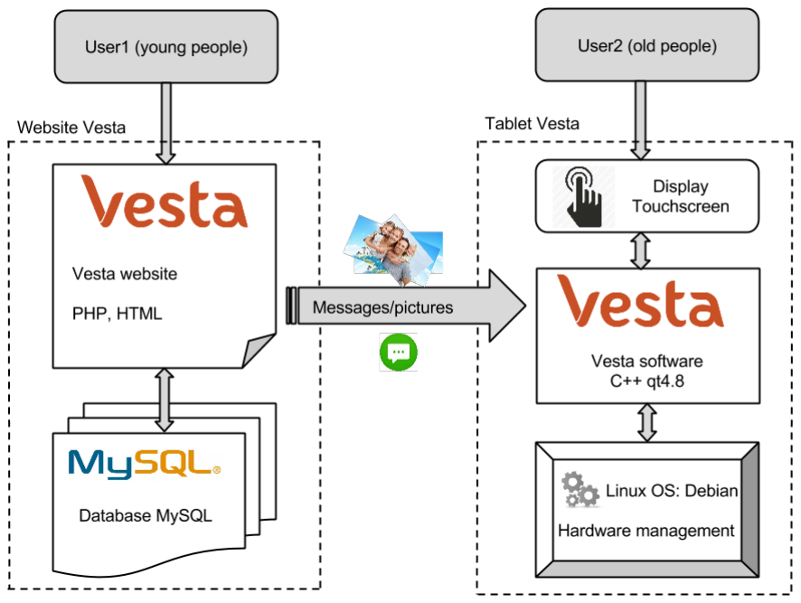
[picture p42: figure]

Figure 7.2 – Basic user flow.

The OS manages the communications with the different hardware. The accelerometer is controled by I2C (to read datas and write configurations). The screen uses different interfaces, I2C for the touch panel and 24bit parallel for the display. The WIFI chip is connected with SDIO and it replaces the emmc memory.

Every protocol and every pins input or output have to be declared in a file called device tree source. In the 3.14 kernel, this file is compiled and become a device tree blob. The compiled version of the file is executed at the OS startup. It initiates the load of the drivers and configures the pins as input, output, pwm or interrupt. Some pins can be configured as i2c, spi, SDIO or some other protocols.

Packets installed on the original debian OS :
- libqt4-core : Defaults tools for Qt software execution
- libqt4-gui : Needed to display GUI software developped with Qt
- dtc : Device tree compiler used to create pin configuration at the OS startup
- wicd : Network manager for WIFI connections
- evtest : Tool for interruption event, used especially to debug the touchscreen

### 7.1.1 Drivers

A lot of work on this linux distribution was made to be fully compatible with the chosen hardware. The touch screen driver edt-ft5x06 had problems with the original 3.8 kernel of the distribution used. The driver was not loading correctly from the device tree overlay. An upgrade to the 3.14 kernel resolved the problem. Then the scale of the touchscreen was not correct. When a touch event occured on the right-down corner, the mouse pointer moved to the center of the screen. Some configuration scripts had to be modified for the X11 graphical display server.

7 SOFTWARE

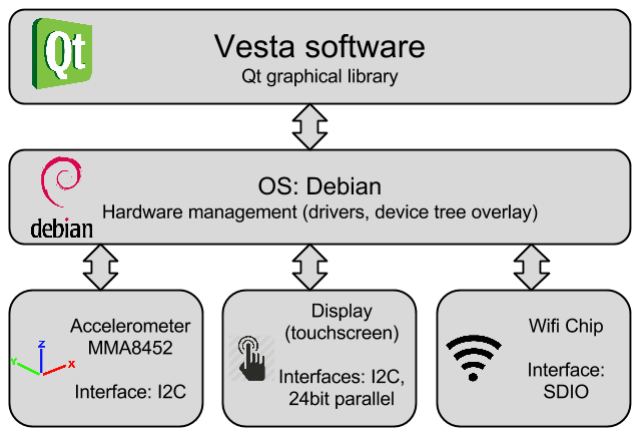
[picture p43: figure]

Figure 7.3 – Firmware dependencies.

The edt-ft5x06 uses an interrupt line and I2C to get the touch events and the positions of the clicks.

Another driver is used for the WIFI connection with the wl1835mod. This driver uses the protocol SDIO. It also has to be declared and initialized at the OS startup in the device tree blob. As the beaglebone’s processor has only one SDIO protocol possible and it is used by the emmc memory, the emmc is replaced by the WIFI chip and the emmc is unusable.

### 7.1.2 Display

The touch screen works with a 24 bits parallel interface so the X11 configuration file had to be modified to work correctly. The LCD output was initialy configured in 16 bits parallel interface. The hardware management in linux is called a device tree blob. It’s a script that is compiled and is loaded at the OS startup. In this file, the driver for the touch panel was declared and the interrupt pins was defined. The resolution and frequency of the display is also configured in this script. The wifi chip also needs to load drivers at startup and tell the OS to connect to internet via this chip and with the SDIO protocol. The file is located in /boot/dtbs/3.14xx/ and is called vesta.dtb (compiled) and the source is called vesta.dts. The file uEnv.txt located in /boot/ also needs to define which device tree blob(dtb) the OS has to load at startup.

### 7.2 Website

The website is used by the young users to send messages and pictures to the old user’s tablet. The website contains a MySQL database, a php/html page that let the young user send a message and a php script used to parse the database to XML to be readable by the tablet.

J. Bregnard, I. Ayrton | 19

7 SOFTWARE

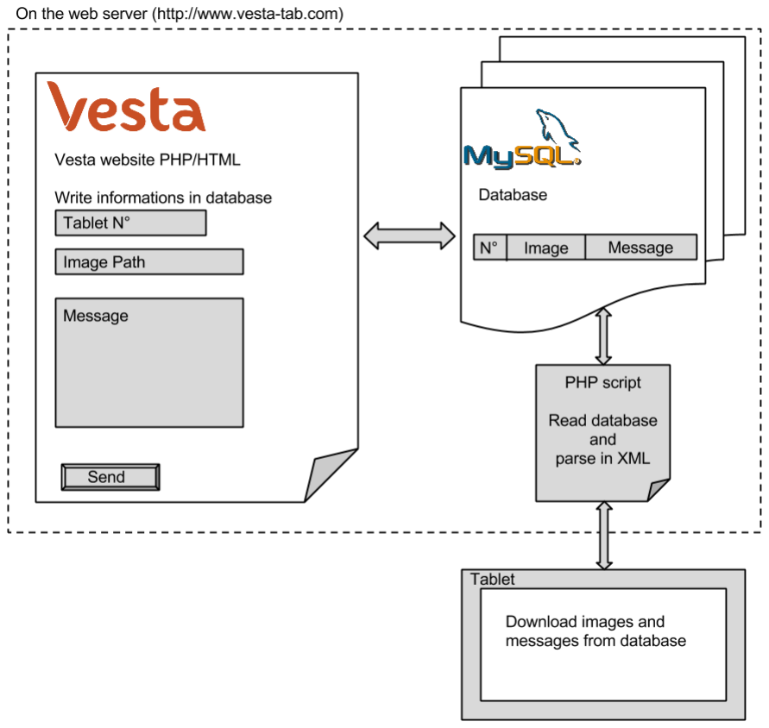
[picture p44: figure]

Figure 7.4 – Vesta website architecture.

### 7.2.1 Webpage

The webpage let the young user send a message to a wanted tablet. Every tablet has an id like a phone number known by the tablet owner. It is possible to select a picture on the user’s computer and write a text message. When the ”send” button is clicked, the picture and text message is saved in the MySQL database.

The php script called when the send button is clicked downloads the picture contained in the file input, verify if the file downloaded is a picture and if the size is not too big. If everything went well the picture and the other datas are saved in the MySQL database else some error messages are displayed. The date is automatically written at the current time.

### 7.2.2 Database and XML parsing

The MySQL database is where all the messages and pictures are stored. The webpage connects and save the datas into the database when the user send a message.

An example of entries on the vesta table on the MySQL database are shown in the table2.

When the tablet update the datas, it connects to a script contained on the server. This script connects to the database and parse the informations needed by the tablet in XML.The tablet then unparse the datas, downloads the pictures, and displays them.

7 SOFTWARE

id | type | name | sender | text | img | date
7 8 | image/jpeg image/jpeg | family.jpg cat.jpg | Jean Marie | Hello ! A message for you Look at my cat :) | BLOB - 300KB BLOB - 350KB | 14.05.2015 27.05.2015

Table 2 – Example of entries in the vesta table on the MySQL database

XML is a markup language that facilitates the transfer of datas and the readability of them. It is mainly used in the RSS flux.

An example of XML code is shown below :

< ?xml version=”1.0”?> <vesta> <item> <title>family.jpg</title> <sender>Jean</sender>
<date>2015-04-18 17 :08 :45</date> <image>http ://www.vesta-tab.com/jo/getImage.php ?id=7</image>
<message>Hello ! A message for you</message> </item> <item> <title>cat.jpg</title> <sender>Marie</sender> <date>2015-04-23 14 :34 :12</date> <image>http ://www.vesta-tab.com/jo/getImage.php ?id=8</image> <message>Look at my cat</message> </item> </vesta>

This XML file defines 2 messages : family.jpg and cat.jpg. The senders are Jean and Marie at
respectively 17 :08 :45 the 18th april 2015 and 14 :34 :12 the 23th april 2015. The images are available at the URL defined between the image markups. The message is between the message markups.

### 7.3 Vesta software on the tablet

The Vesta software is used by the old users to receive and display the messages and pictures sent by the young users. It is located on the tablet and working with debian. The software is made in C++ with Qt4.8/Qt quick 1.0.

### 7.3.1 Qt library

Qt is a free library used mainly to design softwares with graphical user interfaces (GUI). It is cross platform so with the same code it is possible to compile for linux,windows and mac. The library contains also a lot of utils to facilitate the development of emmbedded interfaces and manages the touchscreen events like the swipes, clicks and more. A lot of documentation is available and a lot of users develop with it.

There are differents GUI library like Gtk+, CEGUI etc... The choice of Qt was done especially because it is cross platform but also because it’s compatible with emmbedded systems. Qt can be used also with android and IOS and is really made for apps with touchscreen. Qt quick is very powerful for emmbedded applications. The last version of Qt was downloaded over 1 million times and is ranked number 1 of all cross-platform tools.

Qt creator is the official development environnment for Qt. It is used to develop and cross-compile the software for the beaglebone black. A visual GUI editor is available and simplify grandly the development of the software GUI.

### 7.3.2 Overall operations

At the startup, the vesta tab init and check the wifi connection. The touchscreen creates an event when someone touch it and changes the image displayed. It lets the user naviguate between the different messages. Every minute the soft check if a new message is received.

The software is quite simple and not a lot of functionnalities are implemented. The goal was to have a really easy to use software for old people.

J. Bregnard, I. Ayrton | 21

7 SOFTWARE

The figure 7.5 shows how the software works.

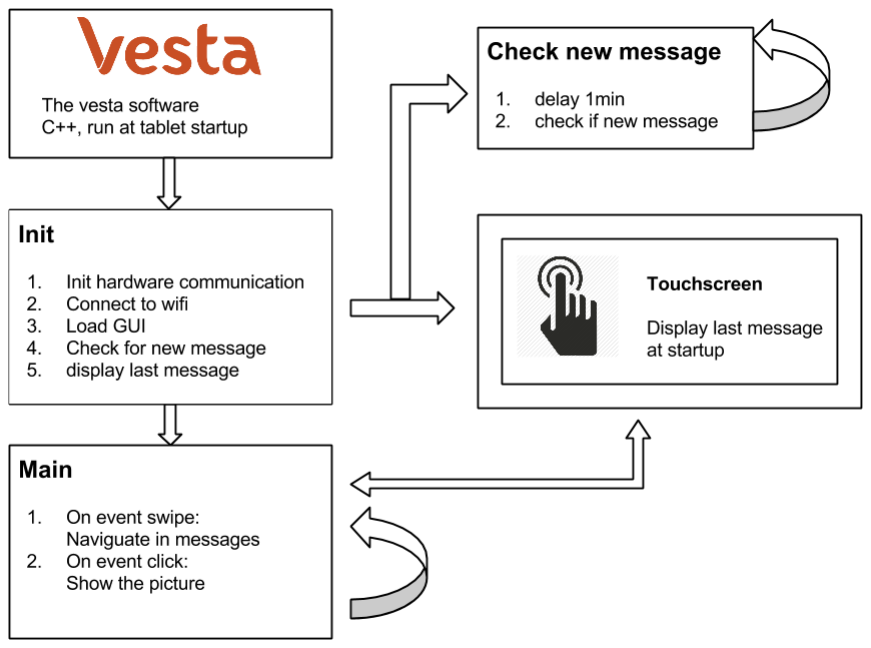
[picture p45: figure]

Figure 7.5 – Vesta software architecture.

### 7.3.3 Graphical interface

The graphical interface is composed of an horizontal listview and some buttons. The listview allows swipes event to naviguate between the different pictures and messages.

A task bar is always visible on the top of the GUI. The list view displays the actual picture, the date when the messages was sent and the text message.

The buttons let the user configure the wifi or display the new messages.

- The button A refresh the messages and display the last one.
- The button B goes to the WIFI configuration and indicates the RSSI of the WIFI.
- The indicator C show the battery level

The figure 7.6 shows how the GUI is constructed.

The figure 7.7 shows the actual GUI.

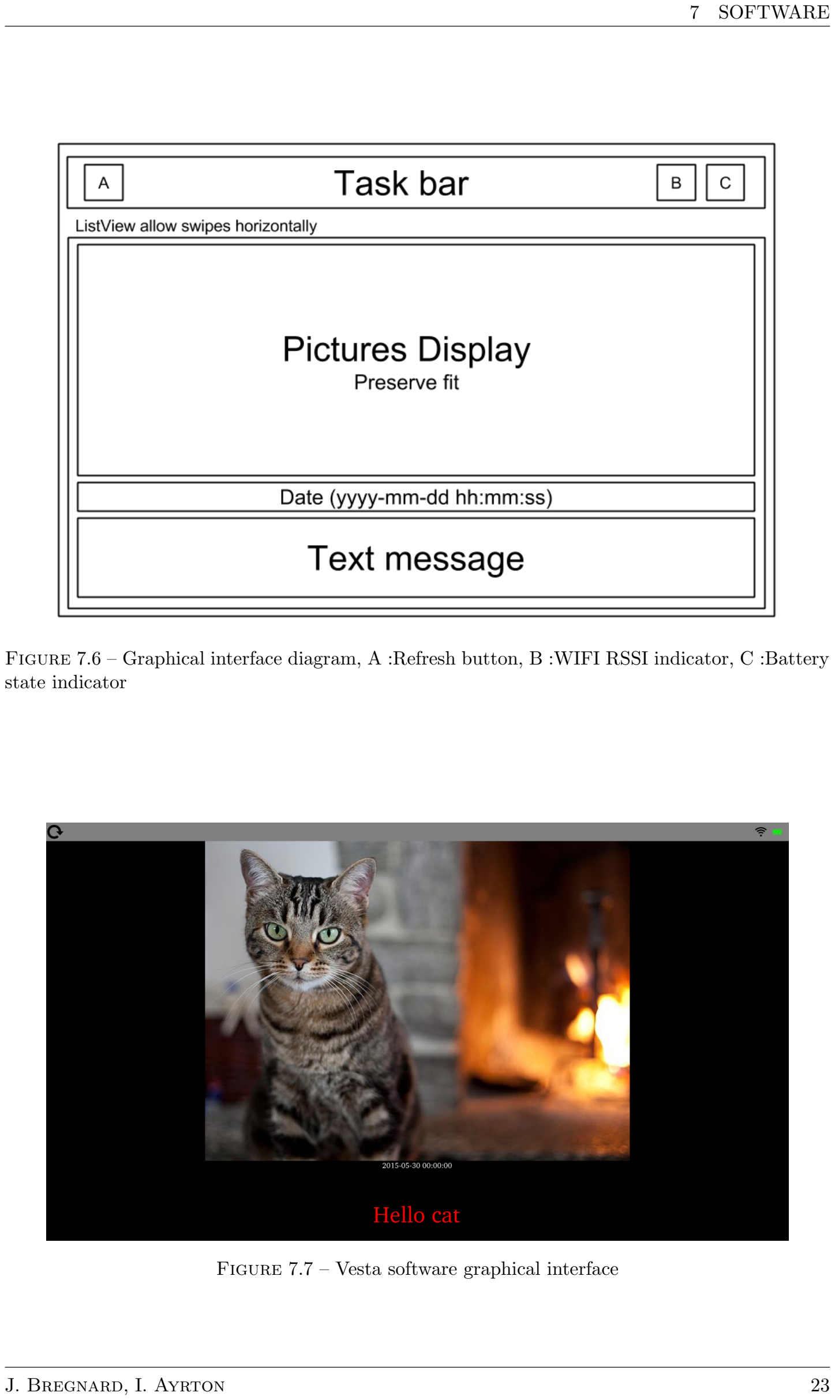
[picture p46: page 25]

7 SOFTWARE

Figure 7.6 – Graphical interface diagram, A :Refresh button, B :WIFI RSSI indicator, C :Battery state indicator

Figure 7.7 – Vesta software graphical interface

J. Bregnard, I. Ayrton | 23

9 PROBLEMS ENCOUNTERED

## 8 Next steps

In the beginning of july, a first prototype will be made in Shenzen (China) with an industrial partner (Seedstudio). A final presentation of the project is going to take place in october with the prototype.

A lot of fonctionnalities could be easily implemented after this prototyping step. An activity monitoring or an emergency call system for example. Another fonctionnality can be a videoconference system with a camera like Skype do. This device has a lot of unused connections that could be used to connect other sensors for medical assistance. It can becomes an electrocardiogram for example. The advantage is that the hardware is powerful enough to do almost everything a computer can do in therm of connectivity. Everything that can be done with a tablet can be done with this device and more.

< HEAD The device contains bluetooth ======= The device contains bluetooth integrated in the WIFI chip and is not currently used. Bluetooth could be used to have more interactions with other devices or to configure the tablet. For example the configuration and selection of the WIFI network can be done via an app on a smartphone with bluetooth. Or an activity tracker bracelet could upload the datas to the tablet. The tablet would be used to display the activity in some plots.

The software can be changed relatively easily and do a completely different task. Qt is a well known library that let the programmer creates interfaces very fast. This device may become a developpement board.

Currently the only way to send messages or pictures is trough the website. A next step could be to develop an app on IOS and android to send pictures directly from a smartphone or a tablet.

## 9 Problems encountered

The main problems encountered were about the OS configuration and compatibility with the hardware components. The driver for the I2C capacitive touch panel chip wasn’t working with the kernel 3.8. The driver was loading at the OS startup but no input was available to read it. This problem was resolved by upgrading the kernel to the 3.14 version. The scale of the touchscreen was not working also. The events were readable but they were wrong, the clicks were not synchronized with the screen size. Some calibration configurations of the X11 config file resolved the problem.

> origin/master

10 CONCLUSION

## 10 Conclusion

The software is not finished yet but the hardware and design is already well implemented. The priority was placed on the hardware and the design. These two parts must be finished before going to China but the software can be finished afterwards.

J. Bregnard, I. Ayrton | 25
