jbregnard/vesta/bbb-xml-qt4.8.2/full-battery_design.png

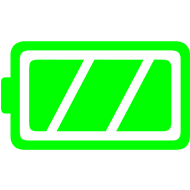
bbb-xml-qt4.8.2/full-battery_design.png
