jbregnard/vesta/beaglebone-qt4.8.2/IMAGES/6.jpg

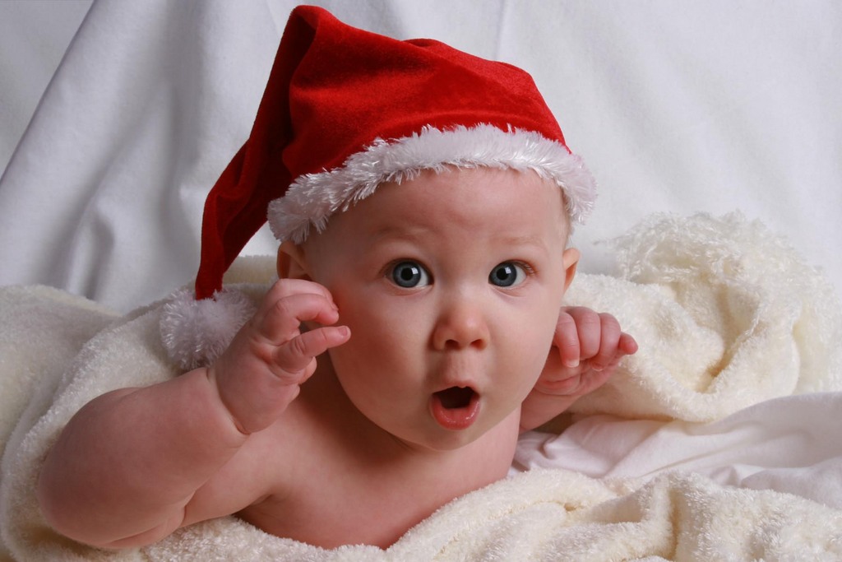
beaglebone-qt4.8.2/IMAGES/6.jpg
