jbregnard/vesta/beaglebone-qt4.8.2/IMAGES/29.jpg

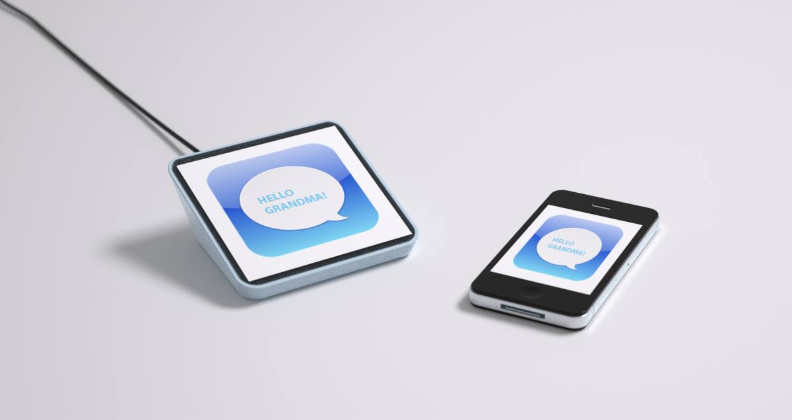
beaglebone-qt4.8.2/IMAGES/29.jpg
