jbregnard/vesta/Rapports/vesta_latex_repport/chap/buisnessFig/buisness_model.png

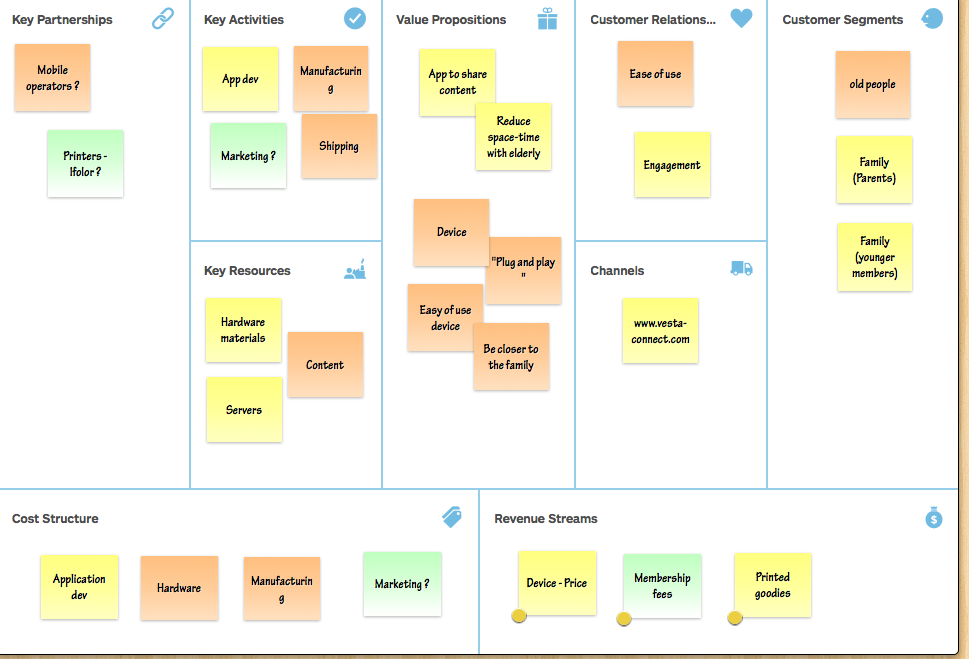
Rapports/vesta_latex_repport/chap/buisnessFig/buisness_model.png
