jbregnard/vesta/Rapports/vesta_latex_repport/chap/designFig/VestaRechercheIdentity4.jpg

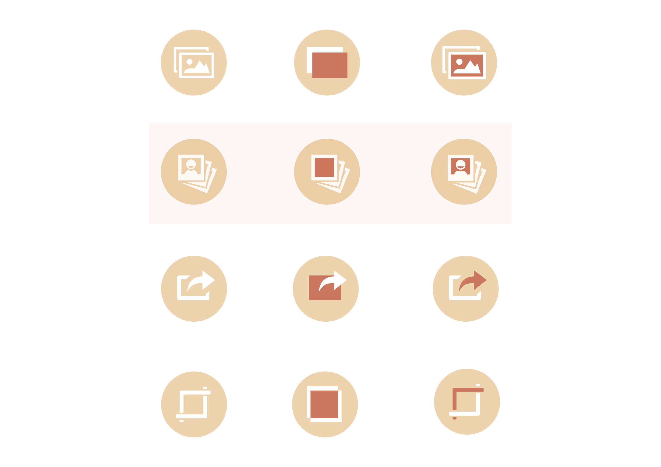
Rapports/vesta_latex_repport/chap/designFig/VestaRechercheIdentity4.jpg
