jbregnard/vesta/Rapports/vesta_latex_repport/chap/designFig/VestaRechercheIdentity.jpg

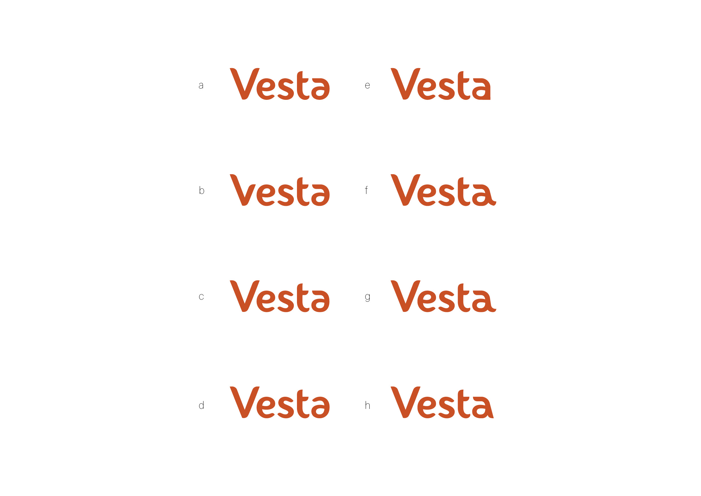
Rapports/vesta_latex_repport/chap/designFig/VestaRechercheIdentity.jpg
