jbregnard/vesta/Rapports/vesta_latex_repport/chap/hardFig/antenna_image.jpg

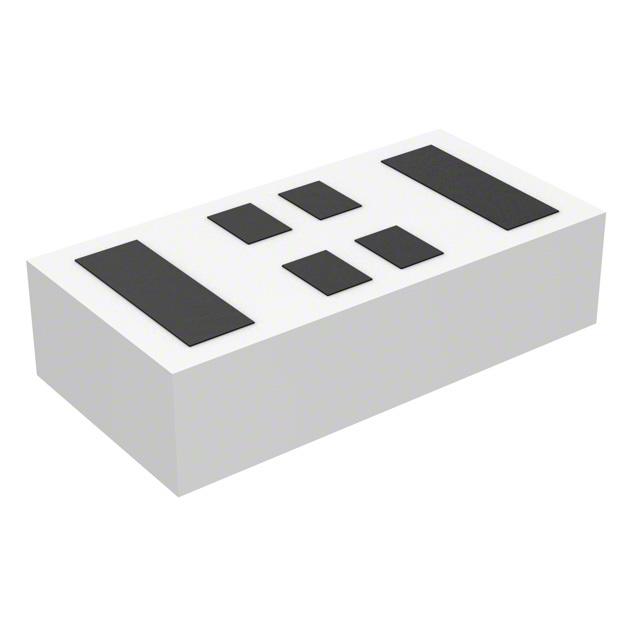
Rapports/vesta_latex_repport/chap/hardFig/antenna_image.jpg
