jbregnard/vesta/Rapports/vesta_latex_repport/chap/hardFig/layer stack manager.png

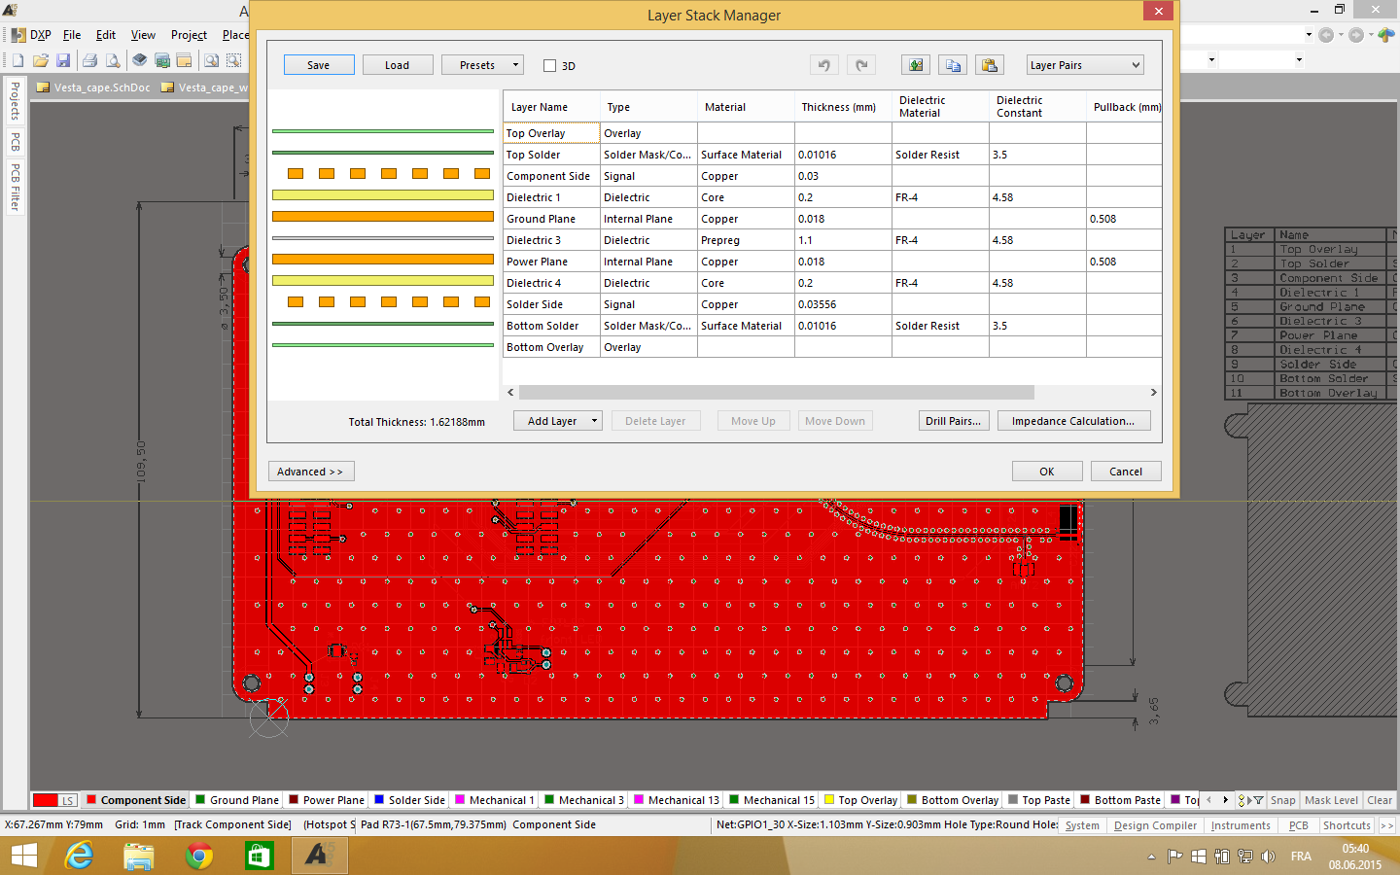
Rapports/vesta_latex_repport/chap/hardFig/layer stack manager.png
