jbregnard/vesta/Rapports/vesta_latex_repport/chap/hardFig/wl1835_buffering_sch.png

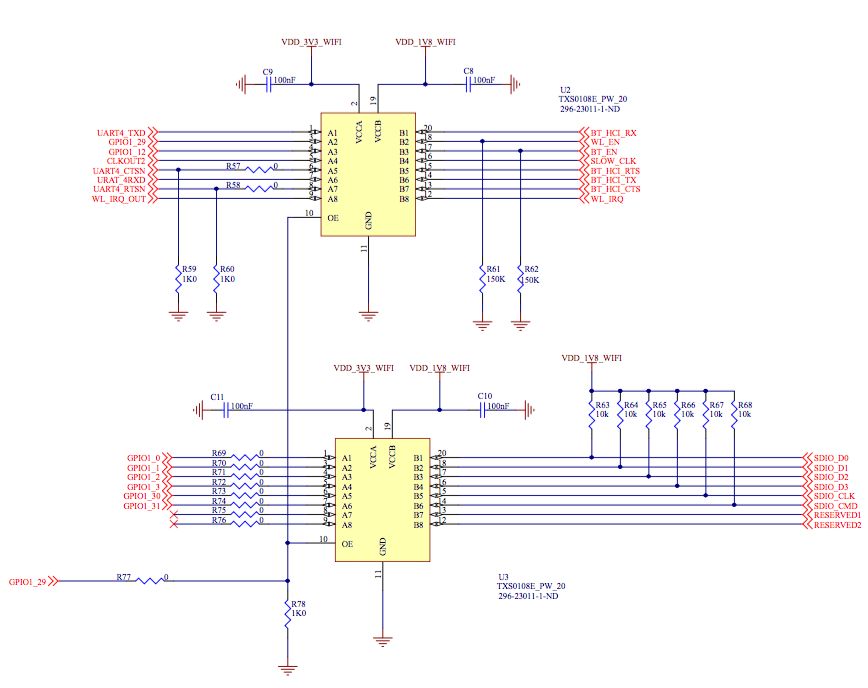
Rapports/vesta_latex_repport/chap/hardFig/wl1835_buffering_sch.png
