jbregnard/vesta/Rapports/vesta_latex_repport/chap/hardFig/WL1835_package.jpg

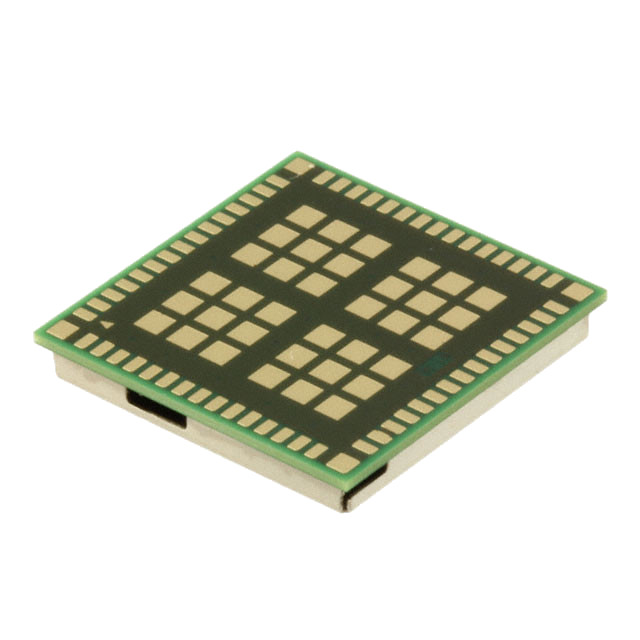
Rapports/vesta_latex_repport/chap/hardFig/WL1835_package.jpg
