jbregnard/vesta/Rapports/vesta_latex_repport/chap/marketFig/family_value_prop_canvas.png

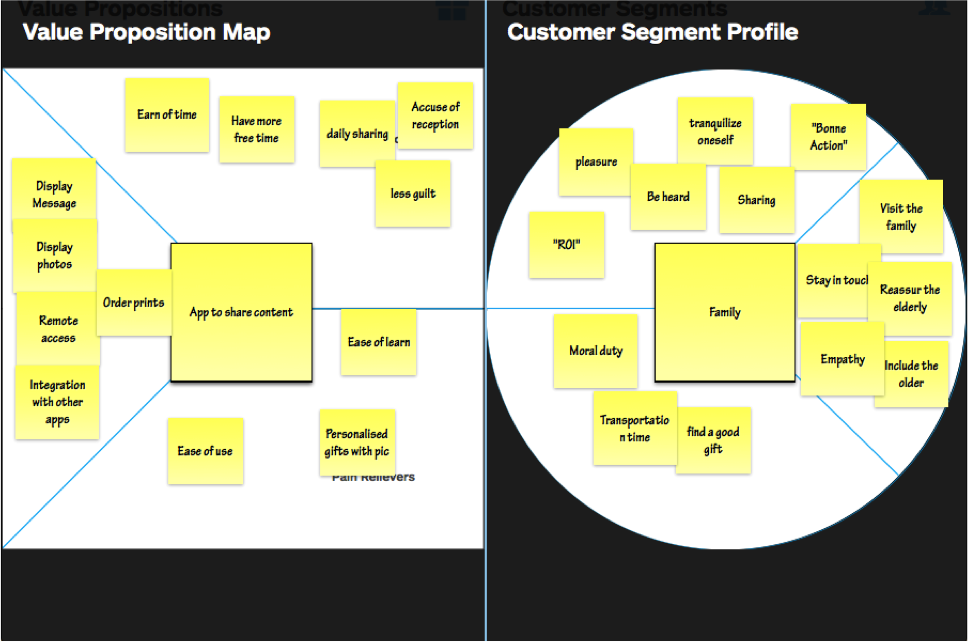
Rapports/vesta_latex_repport/chap/marketFig/family_value_prop_canvas.png
