jbregnard/vesta/Rapports/vesta_latex_repport/chap/marketFig/growing_elderly_europop2013.png

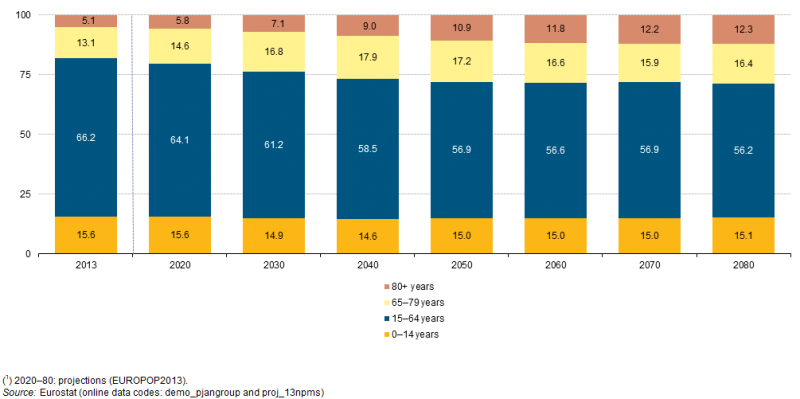
Rapports/vesta_latex_repport/chap/marketFig/growing_elderly_europop2013.png
