jbregnard/vesta/vesta_bom_10_06_2015.xls

Bill of material group Vesta |  |  |  |  | CHIC2015
Comment | Description | Designator | Footprint | LibRef | Quantity
U.FL-R-SMT | smd coaxial hirose connector | ANT1, ANT2 | U.FL-R-SMT | U.FL-R-SMT | 2
jst connector | Jst 2mm 2 circuits SM4 top entry type connector | BAT IN, COIL IN, front LED1 | JMP1X2-F180_2.54 | JST-2 | 3
CN3065 |  | Bat_charger | CN3065-LIPO | CN3065 | 1
FAN5333B-LCD-backlight |  | BCKLGHT1 | 5-lead SOT23 | FAN5333B | 1
100nF | Capacitor (Semiconductor SIM Model) | C1 | C1206 | Cap Semi | 1
10pF | Capacitor (Semiconductor SIM Model) | C2, C5, C6, C7 | C0603 | Cap Semi | 4
2.2pF | Capacitor (Semiconductor SIM Model) | C3, C4, C8, C9 | C0603 | Cap Semi | 4
Cap Semi | Capacitor (Semiconductor SIM Model) | C10, C11 | C2512 | Cap Semi | 2
100nF | Capacitor (Semiconductor SIM Model) | C12, C13 | C2512 | Cap Semi | 2
10uF | Capacitor (Semiconductor SIM Model) | C14, C15, C21, C24, C25 | C1206 | Cap Semi | 5
100pF | Capacitor (Semiconductor SIM Model) | C16, C17, C18 | C1206 | Cap Semi | 3
0.1uF | Capacitor (Semiconductor SIM Model) | C19 | C1206 | Cap Semi | 1
1uF | Capacitor (Semiconductor SIM Model) | C20, C22, C23 | C1206 | Cap Semi | 3
BAT54 | Schottky Barrier Diode, 30 V, 2 uA, -55 to 150 degC, 3-Pin SOT23, RoHS, Tape and Reel | D1, D2 | NXP-SOT23-3_V | CMP-0417-00004-1 | 2
FAN5333B-front-LED |  | FRTLED1 | 5-lead SOT23 | FAN5333B | 1
54104-4031 | 0.5 mm Pitch Easy-On(TM) Type FPC Connector, 2.0 mm Mated Height, Right Angle, ZIF, SMT, Top Contact, 40 Circuits, -20 to 85 degC, ELV and RoHS Compliant, Tape and Reel | J1 | MOLX-54104-4031 | MOLX-54104-4031 | 1
52271-0679 | 1.0 mm Pitch Easy-On(TM) Type FPC Connector, 3.0 mm Mated Height, Right Angle, ZIF, SMT, Bottom Contact, 6 Circuits, -40 to 85 degC, ELV and RoHS Compliant, Tape and Reel | J2 | MOLX-52271-0679 | MOLX-52271-0679 | 1
1.5nH | Inductor | L1, L2 | 0402-A | Inductor | 2
10uH | Inductor | L3, L4 | 0402-A | Inductor | 2
Header 2 | Header, 2-Pin | P1, P2 | HDR1X2 | Header 2 | 2
P8 | Beaglebone Black-P8-smt header from samtec TSM-1-23-03-L-DV | P8 | HEADER_23_2_SMD | HDR_2_23_M_P8 | 1
P9 | Beaglebone Black-P8-smt header from samtec TSM-1-23-03-L-DV | P9 | HEADER_23_2_SMD | HDR2-23-M-P9 | 1
ANTENNA | Ceramic antenna from TDK ANT016008LCD2442MA1 | PANT1, PANT2 | ANT_BRD_CUT | ANTENNA | 2
0 | Resistor | R1, R3, R4, R5, R6, R7, R8, R9, R10, R11, R12, R13, R14, R15, R16, R17, R18, R19, R20, R21, R22, R23, R24, R35, R36, R37, R38, R39, R40, R41, R42, R43, R47, R48, R49, R50, R51, R52, R53, R54, R55, R56, R57, R58, R59, R60, R61, R62, R63, R64, R65, R66, R67, R68, R69, R70, R71, R72, R73, R74, R75 | J1-0603 | Res3 | 61
1K0 | Resistor | R2, R25, R26, R44 | J1-0603 | Res3 | 4
150K | Resistor | R27, R28 | J1-0603 | Res3 | 2
10k | Resistor | R29, R30, R31, R32, R33, R34 | J1-0603 | Res3 | 6
7.15K | Resistor | R45 | J1-0603 | Res3 | 1
4.12K | Resistor | R46 | J1-0603 | Res3 | 1
4.7k | Resistor | R76, R77, R79, R80 | J1-0603 | Res3 | 4
6 | Resistor | R78 | J1-0603 | Res3 | 1
2.2k | Resistor | R81 | J1-0603 | Res3 | 1
100 | Resistor | R82 | J1-0603 | Res3 | 1
43k | Resistor | R83 | J1-0603 | Res3 | 1
30k | Resistor | R84 | J1-0603 | Res3 | 1
WG7835-T0B module_ref_130904_wl1835 | WIFI + bluetooth module from Ti | U1 | E-13.4X13.3-N100_0.75-TOP | WG7835-T0B module_ref_130904 | 1
TXS0108E_PW_20 | 8-Bit Bidirectional Voltage-Level Translator | U2, U3 | PW20 | TXS0108E_PW_20 | 2
TL1963ADCQT | Single Output Fast Transient Response LDO, 1.5 A, Adjustable 1.21 to 20 V Output, 2.1 to 20 V Input, 6-pin SOT-223 (DCQ), -40 to 125 degC, Green (RoHS & no Sb/Br) | U4 | TI-DCQ6_M | CMP-0395-00365-1 | 1
TPS73618DBVR | Single Output Low Noise LDO, 400 mA, Fixed 1.8 V Output, 1.7 to 5.5 V Input, with Reverse Current Protection, 5-pin SOT-23 (DBV), -40 to 85 degC, Green (RoHS & no Sb/Br) | U5 | TI-DBV5_N | CMP-0395-00289-1 | 1
ADXL345BCCZ-RL7 | 3-Axis, +/-2 g / +/-4 g / +/-8 g / +/-16 g Digital Accelerometer with Digital Output, 1.6 KHz BW, Industrial, 14-pin LGA, Reel | U6 | ADI-CC-14-1_V | CMP-0885-00033-1 | 1
ASH7K-32.768KHz-T | Crystal Oscillator, 32.768 kHz, -40 to 80 degC, 3.2 x 1.5 x 1.0 mm SMD, Tape and Reel | X1 | ABRA-ASH7K-4_V | CMP-0448-00001-2 | 1
Touchscreen | NHD-7.0-800480EF-ATXL |  |  |  | 1
