jbregnard/vesta/Templates seeed/Vesta_BOM.xlsx

Sheet: Seeed BOM Format
Electronic Engineering BOM List
Product Name： EG GG Button | Vesta
Version：V1.0
Issue Date：21/5/2012 | 2015-06-10
Item No. (序号) | Reference Des (上件位置) | Qty (用量) | Catalog (分类） | Part_Description (规格描述) | Part_Value （元件值） | Part_Package （元件封装） | Manufacturers Name (使用厂牌名称) | Manufacturers Part No. (使用厂牌型号) | Distributors Name （供应商名称） | Distributors Part No. (供貨商型号) | Unit Price （单价） | Price Break To Use （价格分段的购买量） | Notes/Remark （备注）
Example（填写范例）
1 | ANT1, ANT2 | 2 | Connector | RF Connectors / Coaxial Connectors | nan | C0805 | Hirose | U.FL-R-SMT(10) | Mouser | 798-U.FL-R-SMT10 | $1.20
2 | BAT IN, COIL IN, front LED1 | 3 | Connector | Jst 2mm 2 circuits SM4 top entry type connector | nan | jst | JST Sales America Inc | B2B-PH-SM4-TB(LF)(SN) | Digikey | 455-1734-2-ND | $0.53
3 | Bat_charger | 1 | IC | CN3065 from lipo rider pro from Seeedstudio | nan | DFN-8 | Consonance electronic | CN3065 | Seeedstudio ? | ? | ? |  | Could we get this part through Seeedstudio?
4 | BCKLGHT1, FRTLED1 | 2 | IC | High Efficiency, High Current Serial LED Driver | nan | 5-Lead SOT-23 | Fairchid semiconductor | FAN5333BSX | Mouser | 512-FAN5333BSX | $1.10
5 | C1,C19 | 2 | Capacitor | capacitor | 100nF | C1206 | Yageo | CC1206KKX7R0BB104 | Mouser | 603-CC206KKX7R0BB104 | $0.211
6 | C2, C5, C6, C7 | 4 | Capacitor | capacitor | 10pF | C0603 | Yageo | CC1206JRNPO9BN100 | Mouser | 603-C1206JRNPO9BN100 | $0.111
7 | C3, C4, C8, C9 | 4 | Capacitor | capacitor | 2.2pF | C0603 | Yageo | CC1206CRNPO9BN2R2 | Mouser | 603-CC126CRNPO9BN2R2 | $0.166
8 | C10, C11 | 2 | Capacitor | capacitor | 100nF | C1206 | Yageo | CC1206KKX7R0BB104 | Mouser | 603-CC206KKX7R0BB104 | $0.211 |  | Must change footprint in PCB
9 | C12, C13 | 2 | Capacitor | capacitor | 100nF | C1206 | Yageo | CC1206KKX7R0BB104 | Mouser | 603-CC206KKX7R0BB104 | $0.211 |  | Must change footprint in PCB
10 | C14, C15, C21, C24, C25 | 5 | Capacitor | capacitor | 10uF | C1206 | Yageo | CC1206KKX5R8BB106 | Mouser | 603-CC206KKX5R8BB106 | $0.31
11 | C16, C17, C18 | 3 | Capacitor | capacitor | 100pF | C1206 | Yageo | CC1206JRNPO9BN101 | Mouser | 603-CC126JRNPO9BN101 | $0.188
12 | C20, C22, C23 | 3 | Capacitor | capacitor | 1uF | C1206 | Yageo | CC1206KKX7R7BB105 | Mouser | 603-CC126KKX7R7BB105 | $0.177
13 | D1, D2 | 2 | Diode | Schottky Barrier Diode, 30 V, 2 uA, -55 to 150 degC, 3-Pin SOT23, RoHS, Tape and Reel | nan | 3-lead SOT-23 | NXP semiconductors | BAT54,215 | Mouser | 771-BAT54-T/R | $0.223
14 | J1 | 1 | Connector | 0.5 mm Pitch Easy-On(TM) Type FPC Connector, 2.0 mm Mated Height, Right Angle, ZIF, SMT, Top Contact, 40 Circuits, -20 to 85 degC, ELV and RoHS Compliant, Tape and Reel | nan | MOLX-54104-4031 | Molex | 54104-4033 | Mouser | 538-54104-4033 | $2.79
15 | J2 | 1 | Connector | 1.0 mm Pitch Easy-On(TM) Type FPC Connector, 3.0 mm Mated Height, Right Angle, ZIF, SMT, Bottom Contact, 6 Circuits, -40 to 85 degC, ELV and RoHS Compliant, Tape and Reel | nan | MOLX-52271-0679 | Molex | 52271-0679 | Mouser | 538-52271-0679 | $1.5
16 | L1, L2 | 2 | OTHER | inductor | 1.5nH | 0402-A | TDK | MHQ0402P1N5ST000 | Mouser | 810-MHQ0402P1N5ST000 | $0.309
17 | L3, L4 | 2 | OTHER | inductor | 10uH | 603 | TDK | MLZ1608E100MT | Mouser | 810-MLZ1608E100MT | $0.139
18 | P1, P2 | 2 | Connector | male smd Header | nan |  | samtec | TSM-102-01-L-SV-TR | Digikey | TSM-102-01-L-SV-TR-ND | $0.296
19 | P8, P9 | 2 | Connector | male Header for Beaglebone Black | nan | 0.100" | Harwin Inc. | M20-8762342 | Digikey | M20-8762342-ND | $1.2528 |  | The connector is 2x23 but only found 2x25
20 | PANT1, PANT2 | 2 | OTHER | Ceramic antenna from TDK ANT016008LCD2442MA1 | nan | 1608 mm | TDK | ANT016008LCD2442MA1 | Mouser | 810-ANT168LCD2442MA1 | $0.65
21 | R1, R3, R4, R5, R6, R7, R8, R9, R10, R11, R12, R13, R14, R15, R16, R17, R18, R19, R20, R21, R22, R23, R24, R35, R36, R37, R38, R39, R40, R41, R42, R43, R47, R48, R49, R50, R51, R52, R53, R54, R55, R56, R57, R58, R59, R60, R61, R62, R63, R64, R65, R66, R67, R68, R69, R70, R71, R72, R73, R74, R75 | 61 | Resister | resistor | 0 | J1-0603 | Yageo | RC0603JR-070RL | Mouser | 603-RC0603JR-070RL | $0.003 (100min)
22 | R2, R25, R26, R44 | 4 | Resister | resistor | 1k | J1-0603 | Yageo | RC0603FR-071KL | Mouser | 603-RC0603FR-071KL | $0.003 (100min)
23 | R27, R28 | 2 | Resister | resistor | 150k | J1-0603 | Yageo | RC0603JR-07150KL | Mouser | 603-RC0603JR-07150KL | $0.003 (100min)
24 | R29, R30, R31, R32, R33, R34 | 6 | Resister | resistor | 10k | J1-0603 | Yageo | RC0603FR-1010KL | Mouser | 603-RC0603FR-1010KL | $0.004 (100min)
25 | R45 | 1 | Resister | resistor | 7.15k | J1-0603 | Yageo | RC0603FR-077K15L | Mouser | 603-RC0603FR-077K15L | $0.003 (100min)
26 | R46 | 1 | Resister | resistor | 4.12k | J1-0604 | Yageo | RC0603FR-074K12L | Mouser | 603-RC0603FR-074K12L | $0.003 (100min)
27 | R76, R77, R79, R80 | 4 | Resister | resistor | 4.7k | J1-0605 | Yageo | RC0603FR-074K7L | Mouser | 603-RC0603FR-074K7L | $0.003 (100min)
28 | R78 | 1 | Resister | resistor | 6.04 | J1-0606 | Yageo | RC0603FR-076R04L | Mouser | 603-RC0603FR-076R04L | $0.006(100min)
29 | R81 | 1 | Resister | resistor | 2.2k | J1-0607 | Yageo | RC0603FR-072K2L | Mouser | 603-RC0603FR-072K2L | $0.003 (100min)
30 | R82 | 1 | Resister | resistor | 100 | J1-0608 | Yageo | RC0603FR-07100RL | Mouser | 603-RC0603FR-07100RL | $0.003 (100min)
31 | R83 | 1 | Resister | resistor | 43k | J1-0609 | Yageo | RC0603FR-0743KL | Mouser | 603-RC0603FR-0743KL | $0.003 (100min)
32 | R84 | 1 | Resister | resistor | 30k | J1-0610 | Yageo | RC0603FR-0730KL | Mouser | 603-RC0603FR-0730KL | $0.003 (100min)
33 | U1 | 1 | IC | WiFI + BLUETOOTH chip | nan | 100-pin MOC | Texas Instruments | WL1835MODGBMOCT | Mouser | 595-WL1835MODGBMOCT | $27.26
34 | U2, U3 | 2 | IC | 8-Bit Bidirectional Voltage-Level Translator | nan | TSSOP-20 | Texas Instruments | TXS0108EPWR | Mouser | 595-TXS0108EPWR | $2.33
35 | U4 | 1 | IC | Single Output Fast Transient Response LDO, 1.5 A, Adjustable 1.21 to 20 V Output, 2.1 to 20 V Input, 6-pin SOT-223 (DCQ), -40 to 125 degC, Green (RoHS & no Sb/Br) | nan | SOT-223-6 | Texas Instruments | TL1963ADCQT | Mouser | 595-TL1963ADCQT | $3.45
36 | U5 | 1 | IC | Single Output Low Noise LDO, 400 mA, Fixed 1.8 V Output, 1.7 to 5.5 V Input, with Reverse Current Protection, 5-pin SOT-23 (DBV), -40 to 85 degC, Green (RoHS & no Sb/Br) | nan | SOT-23-5 | Texas Instruments | TPS73618DBVT | Mouser | 595-TPS73618DBVT | $2.62
37 | U6 | 1 | IC | 3-Axis, +/-2 g / +/-4 g / +/-8 g / +/-16 g Digital Accelerometer with Digital Output, 1.6 KHz BW, Industrial, 14-pin LGA, Reel | nan | LGA-14 | Analog Devices | ADXL345BCCZ | Mouser | 584-ADXL345BCCZ | $7.17
38 | X1 | 1 | IC | Crystal Oscillator, 32.768 kHz, -40 to 80 degC, 3.2 x 1.5 x 1.0 mm SMD, Tape and Reel | nan | ? | ABRACON | ASH7K-32.768KHz-T | Mouser | 815-ASH7K-32-768KHZ | $2.46
39 |  | 1 | OTHER | TFT touchscreen | nan | ? | Newhaven | NHD-7.0-800480EF-ATXL#-CTP | Mouser | 763-NHD7.0EFATXL#CTP | $85.57 |  | The screen doesn't appear in the PCB files but it is in the BOM
40 |  | 1 | OTHER | QI Wireless Charging Module Kit - 5V/1A | nan | ? | Seeedstudio | SKU: 800123001 | Seeedstudio | SKU: 800123001 | $19.80
1. Recommended Distributor: Digi-Key, Mouser, Avnet Express, Farnell.
2. Catalog: Capacitor,Resister,Diode,Connector,Transistor,IC,PROTECTOR CATEGORY,OTHER
3. Required Fields: Item No, Reference Des, Qty, Catalog, Part_Value, Part Package
Optional Fields: Part_Description, Manufacturers Name, Manufacturers Part No, Distributors Name, Distributors Part No, Unit Cost, Price break to use, Notes/Remark

Sheet: Part value requirement
分类 Catalog | 元件值 Part_Value
电感 Inductors | Inductance-Current-Tolerance | 电感值-额定电流-容差
磁珠 Ferrite Bead | Impedance-Current Rating | 阻抗-额定电流
电容 Capacitors | Capacitance-Voltage Rated-Tolerance-Dielectric | 电容值-额定电压-容差-材质
电阻 Resistors | Resistance-Tolerance-Power | 电阻值-功率-容差
无源晶振 Crystals | Frequency-Frequency Tolerance-Load Capacitance-ESR (Equivalent Series Resistance) | 频率-频率公差-负载电容-等效串联电阻
有源晶振 Crystal Oscillator | Frequency-Frequency Tolerance-Load Capacitance-ESR (Equivalent Series Resistance) | 频率-频率公差-负载电容-等效串联电阻
