jbregnard/vesta/Templates seeed/PCB Parameter V1..xlsx

Sheet: FR4 PCB
深圳矽递科技有限公司 Seeed Technology Inc.
PCB Technology Requirement Format
PCB Name & Version
PCB Material PCB板材： | FR－4 | PCB Qty PCB 数量 | （ ）
 | Flex PCB(FPC)
Quality: | Prototyping quality | High quality
PCB Size PCB大小： | cm mm inch | ( ) × ( )
PCB Layer PCB层数： | 2 | 4 | other:( )
Thickness PCB厚度： | 0.8mm | 1.2mm | other:( )
 | 1mm | 1.6mm
Copper Weight 铜厚： | 1oz | 2oz | other:( )
PCB Colour 阻焊颜色： | Green 绿色 | White 白色 | Black 黑色
 | Red 红色 | Blue 蓝色 | other:( )
Silkscreen 字符颜色： | White 白色 | Black 黑色 | other:( )
Pads Finished 焊盘喷镀： | (Hasl-lead free) 无铅喷锡 | (Hasl) 含铅喷锡 | (ENIG) 沉镍金
Via solder mask 阻焊覆盖： | solder mask cover 过孔盖油 | solder mask opening 过孔开窗
Minimum trace/space (mm) 最小线宽 |  | Minimum hole size (mm) 最小孔径
Special requirements 特殊工艺： | Yes | (Put requirements here)
Lead time 交期： | Normal lead time (normally 10 -14 days) | Urgent 24 hours | Urgent 48 hours
Comment:
Shipping Address | The quotation will include the shipping cost if you put the address here. Defaulted shipping method is DHL. Please put the address in this format. Phone NO.-Building- street- city- city post code- province - Country

Sheet: Flex PCB
深圳矽递科技有限公司 Seeed Technology Inc.
FPC Technology Requirement / FPC工艺要求
PCB Name
PCB Material PCB板材： | PI | PCB Qty(Max1000 pcs) PCB 数量 | （ ）
PCB Size PCB大小： | cm mm inch | ( ) × ( ) Max: 24cm*30cm
PCB Layer PCB层数： | 1 | 2 | 4
Thickness （+/- 0.05mm） PCB厚度： | 0.08mm | 0.12mm | 0.15mm
Copper Weight 铜厚： | 0.5 oz (12um) | other:( )
PCB Colour 阻焊颜色： | Yellow 黄色 | Silkscreen 字符颜色： | White 白色
Pads Finished 焊盘喷镀： | OSP | (ENIG) 沉镍金
Via solder mask 阻焊覆盖： | solder mask cover 过孔盖油 | Minimum trace/space (0.1 mm) 最小线宽
Minimum hole size (0.2 mm) 最小孔径 |  | Maximum hole size (5 mm) 最大孔径
Special requirements 特殊工艺： | Yes | (Put requirements here)
Comment:
Shipping Address | The quotation will include the shipping cost if you put the address here. Defaulted shipping method is DHL. Please put the address in this format. Building- street- city- city post code- province - Country
