jbregnard/vesta/AssemblageVesta/Dualock3M.SLDPRT

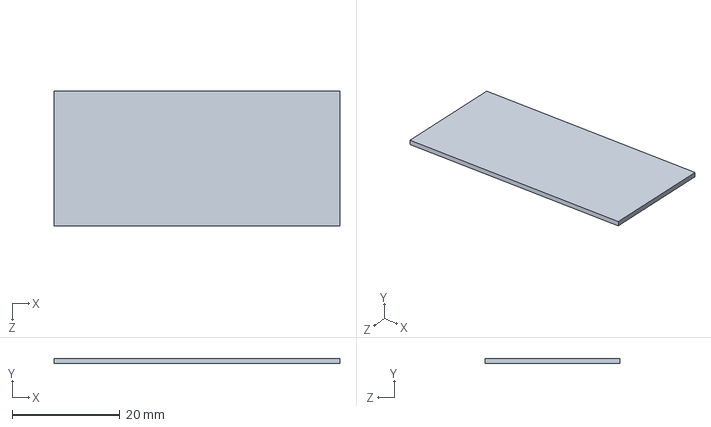
[picture p61: CAD file, 2015-05-07]
AssemblageVesta/Dualock3M.SLDPRT
53.0 x 1.00 x 25.0 mm
