jbregnard/vesta/vesta_pcb_files/2_23_m_header.stp

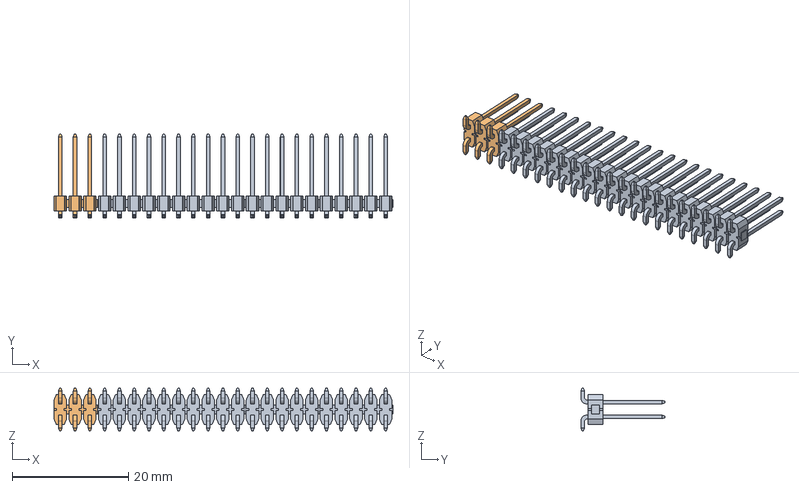
[picture p62: CAD file, 2015-06-06]
vesta_pcb_files/2_23_m_header.stp
58.2 x 14.5 x 7.37 mm
