jbregnard/vesta/AssemblageVesta/Coque.SLDPRT

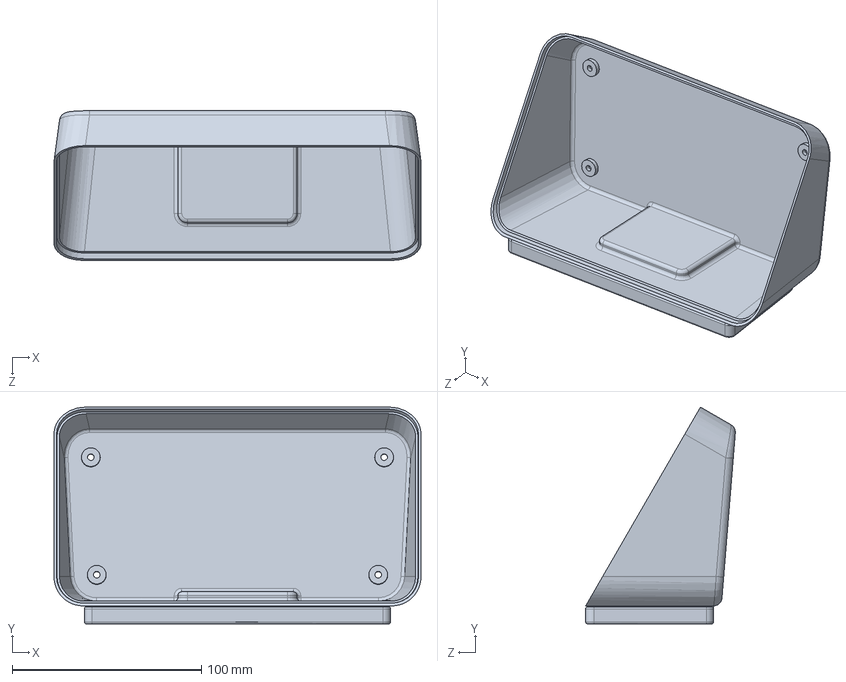
[picture p63: CAD file, 2015-05-07]
AssemblageVesta/Coque.SLDPRT
194.0 x 114.6 x 79.2 mm
