jbregnard/vesta/AssemblageVesta/RXantenna.SLDPRT

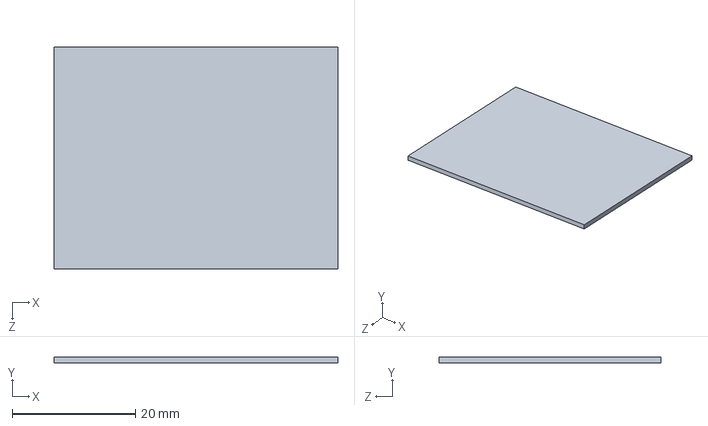
[picture p64: CAD file, 2015-05-07]
AssemblageVesta/RXantenna.SLDPRT
46.0 x 1.00 x 36.0 mm
