jbregnard/vesta/AssemblageVesta/BeaglboneSimple.SLDPRT

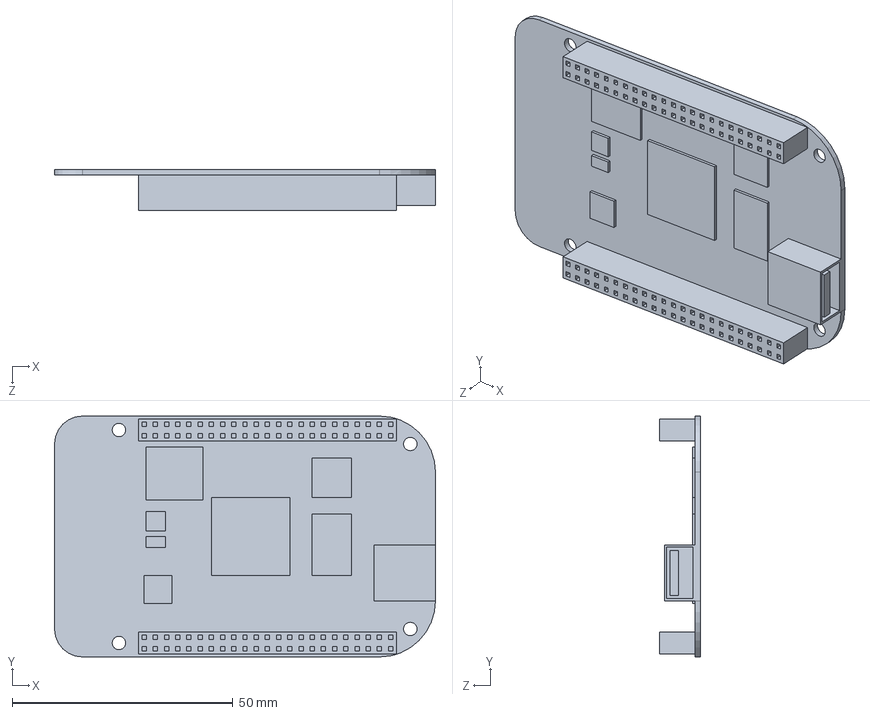
[picture p65: CAD file, 2015-05-07]
AssemblageVesta/BeaglboneSimple.SLDPRT
86.4 x 54.6 x 9.40 mm
