jbregnard/vesta/AssemblageVesta/TXpcba.SLDPRT

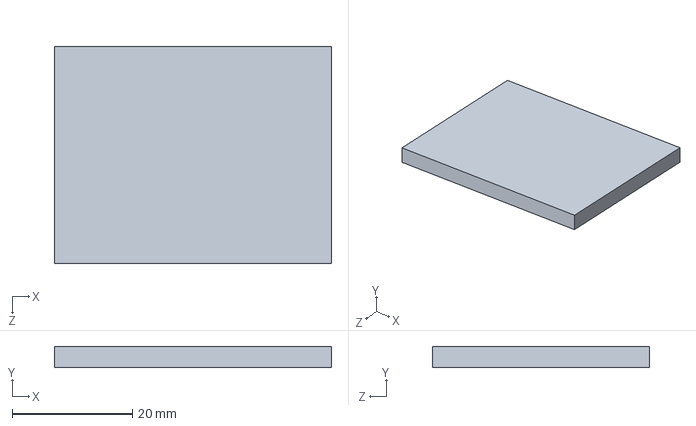
[picture p66: CAD file, 2015-05-07]
AssemblageVesta/TXpcba.SLDPRT
46.0 x 3.50 x 36.0 mm
