jbregnard/vesta/AssemblageVesta/Shell.SLDPRT

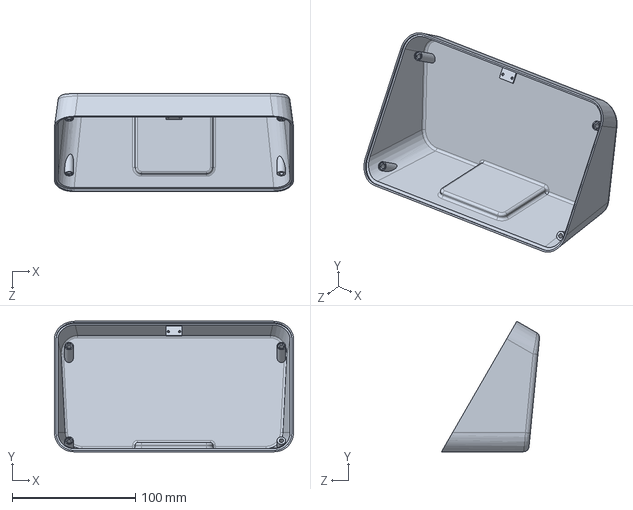
[picture p67: CAD file, 2015-05-07]
AssemblageVesta/Shell.SLDPRT
194.0 x 106.0 x 79.6 mm
