jbregnard/vesta/AssemblageVesta/TXCoil.SLDPRT

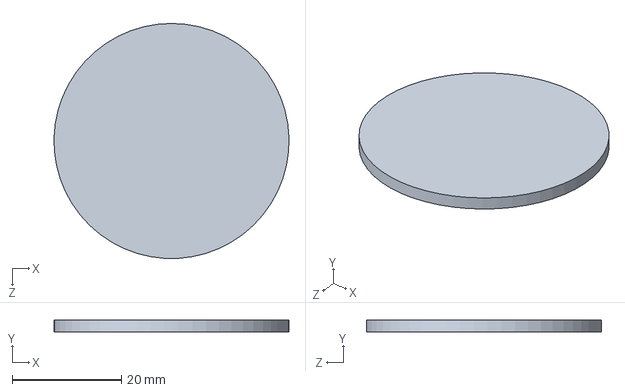
[picture p68: CAD file, 2015-05-07]
AssemblageVesta/TXCoil.SLDPRT
43.0 x 2.20 x 43.0 mm
