jbregnard/vesta/AssemblageVesta/PCBScreen.SLDPRT

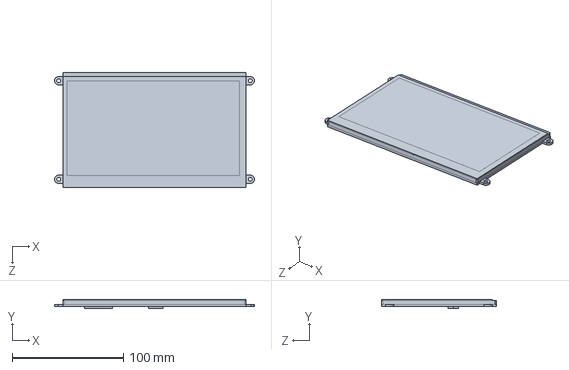
[picture p69: CAD file, 2015-05-07]
AssemblageVesta/PCBScreen.SLDPRT
179.9 x 8.51 x 103.5 mm
