jbregnard/vesta/AssemblageVesta/Vis.sldprt

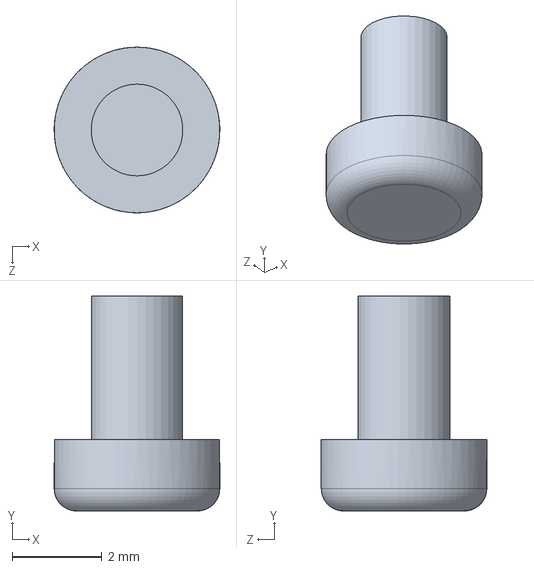
[picture p70: CAD file, 2015-05-07]
AssemblageVesta/Vis.sldprt
3.70 x 4.80 x 3.70 mm
