jbregnard/vesta/AssemblageVesta/Battery.SLDPRT

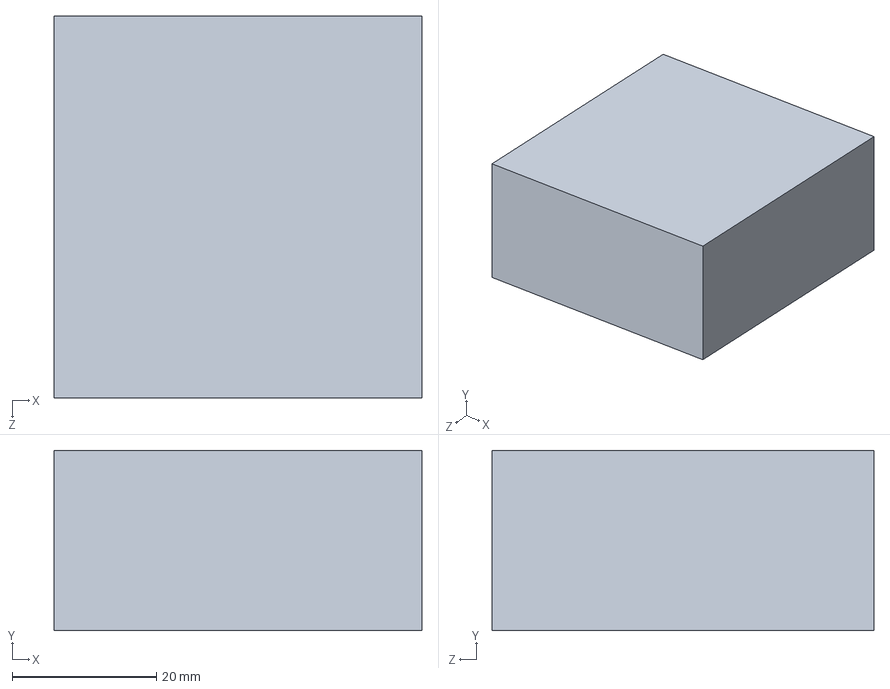
[picture p71: CAD file, 2015-05-07]
AssemblageVesta/Battery.SLDPRT
51.0 x 25.0 x 53.0 mm
