jbregnard/vesta/AssemblageVesta/Led.SLDPRT

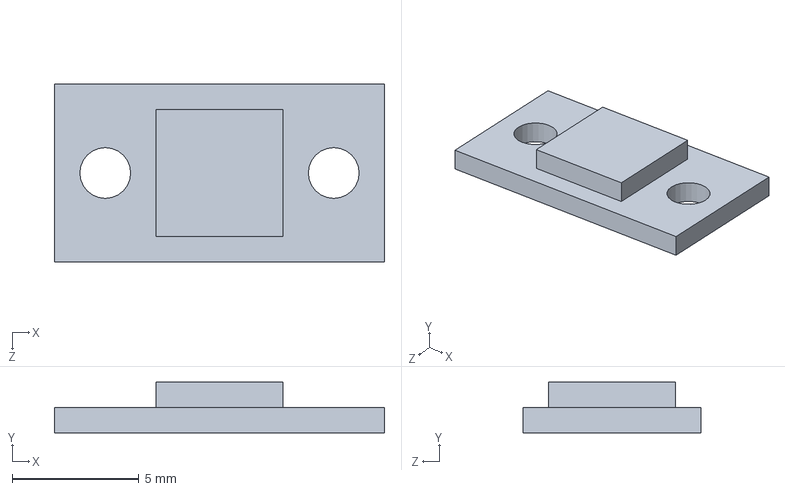
[picture p72: CAD file, 2015-05-07]
AssemblageVesta/Led.SLDPRT
13.0 x 2.00 x 7.00 mm
