jbregnard/vesta/AssemblageVesta/RXfpcb.SLDPRT

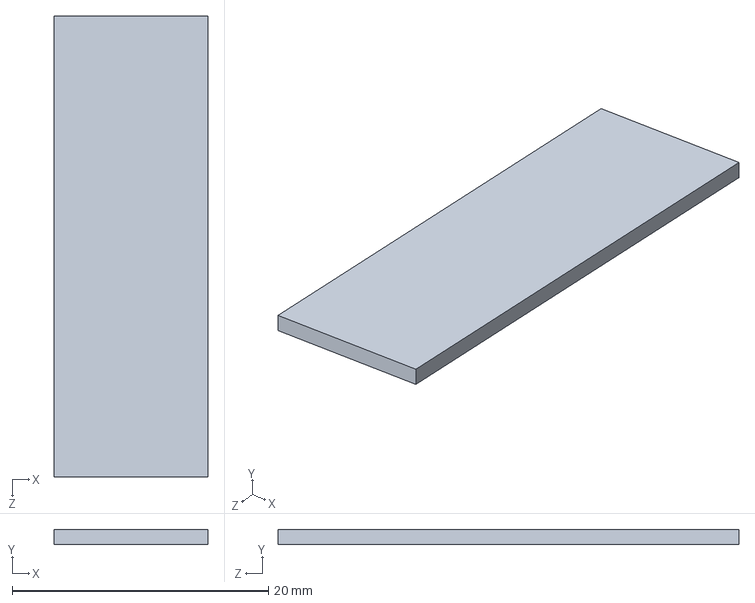
[picture p73: CAD file, 2015-05-07]
AssemblageVesta/RXfpcb.SLDPRT
12.0 x 1.20 x 36.0 mm
