jbregnard/vesta/AssemblageVesta/ScrewPCB.SLDPRT

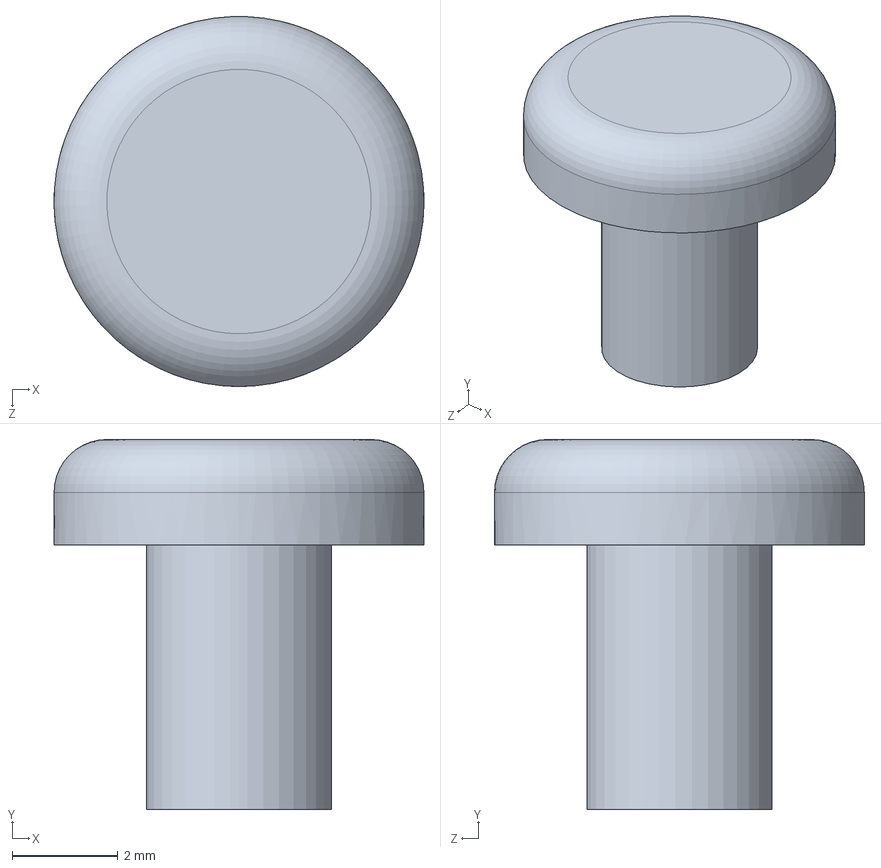
[picture p74: CAD file, 2015-05-07]
AssemblageVesta/ScrewPCB.SLDPRT
7.00 x 7.00 x 7.00 mm
