jbregnard/vesta/(list of files, cad)

Other CAD files:
AssemblageVesta/Frame.sldprt
AssemblageVesta/ChargerClip.sldprt
AssemblageVesta/Charger.sldprt
