jbregnard/vesta/Rapports/vesta_latex_repport/chap/next_steps.tex

\section{Next steps}
\label{chap: next steps}

In the beginning of july, a first prototype will be made in Shenzen (China) with an industrial partner (Seeedstudio). A final presentation of the project is going to take place in october with the prototypes.

A lot of fonctionnalities could be easily implemented after this prototyping step. An activity monitoring or an emergency call system for example. Another fonctionnality can be a videoconference system with a camera like Skype does. This device has a lot of unused connections that could be used to connect other sensors for medical assistance for example. It could become a connected electrocardiogram monitor. The advantage is that the hardware is powerful enough to do almost everything a computer can do in term of connectivity. Everything that can be done with a tablet can be done with this device and more.

The device contains bluetooth integrated in the wl1835 chip and is not currently used. Bluetooth could be used to have more interactions with other devices or to configure the tablet. For example the configuration and selection of the WIFI network can be done via an app on a smartphone with bluetooth. Or an activity tracker bracelet could upload the data to the tablet. The tablet would be used to display the activity in some plots. The family would have a remote monitoring facility.

The software can be changed relatively easily to do a completely different task. Qt is a well known library that let the programmer creates interfaces very fast. This device may become a developpement board.

Currently the only way to send messages or pictures is trough the website. A next step could be to develop an app on IOS and android to send pictures directly from a smartphone or a tablet.

\section{Problems encountered}

The main problems encountered were about the OS configuration and compatibility with the hardware components. The driver for the I2C capacitive touch panel chip wasn't working with the kernel 3.8. The driver was loading at the OS startup but no input was available to read it. This problem was resolved by upgrading the kernel to the 3.14 version. The scale of the touchscreen was also not working. The events were readable but they were wrong, the clicks were not synchronized with the screen size. Some calibration configurations of the X11 config file resolved the problem.

Having no knowledge of PCB design prior to this project, the learning curve was steep. Information was sometimes sparse on specific subjects such as for the antenna footprints.

Getting information on some parts especially from chinese providers was sometimes impossible. For these reasons some of the parts were very expensive.
