jbregnard/vesta/AssemblageVesta/Capture2.PNG

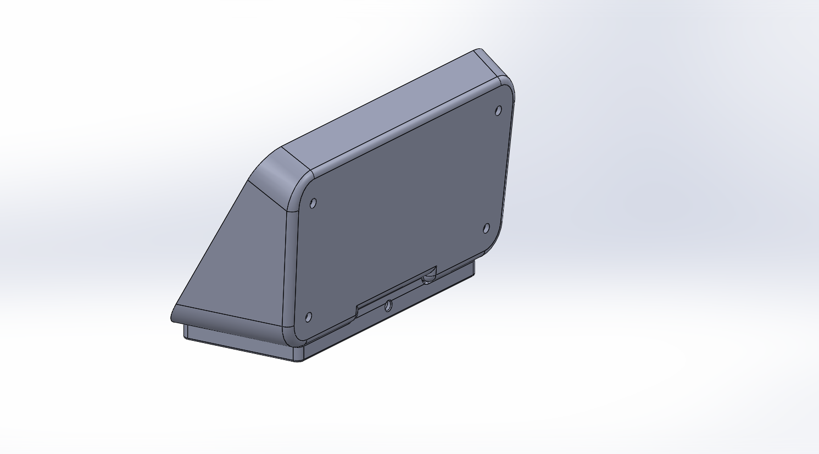
AssemblageVesta/Capture2.PNG
