jbregnard/vesta/AssemblageVesta/Capture.PNG

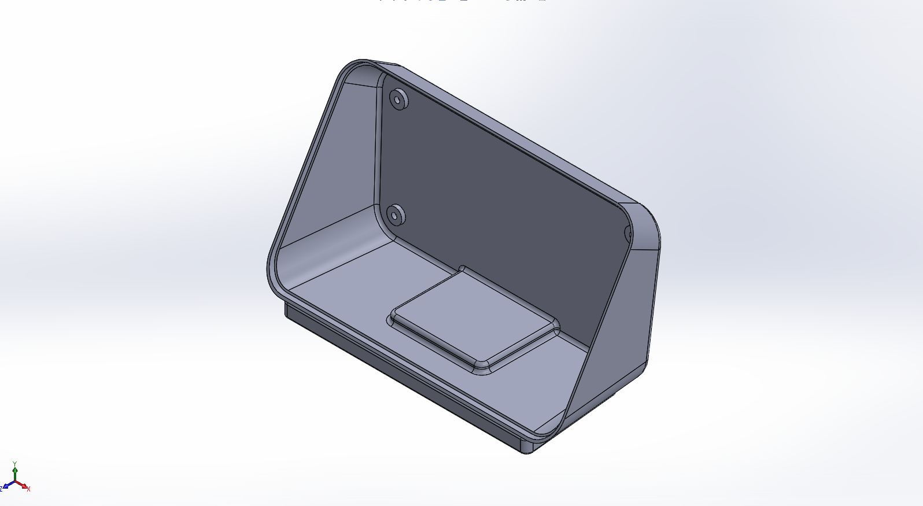
AssemblageVesta/Capture.PNG
