jbregnard/vesta/Rapports/vesta_latex_repport/chap/designFig/AssemblageVestaD_290415.JPG

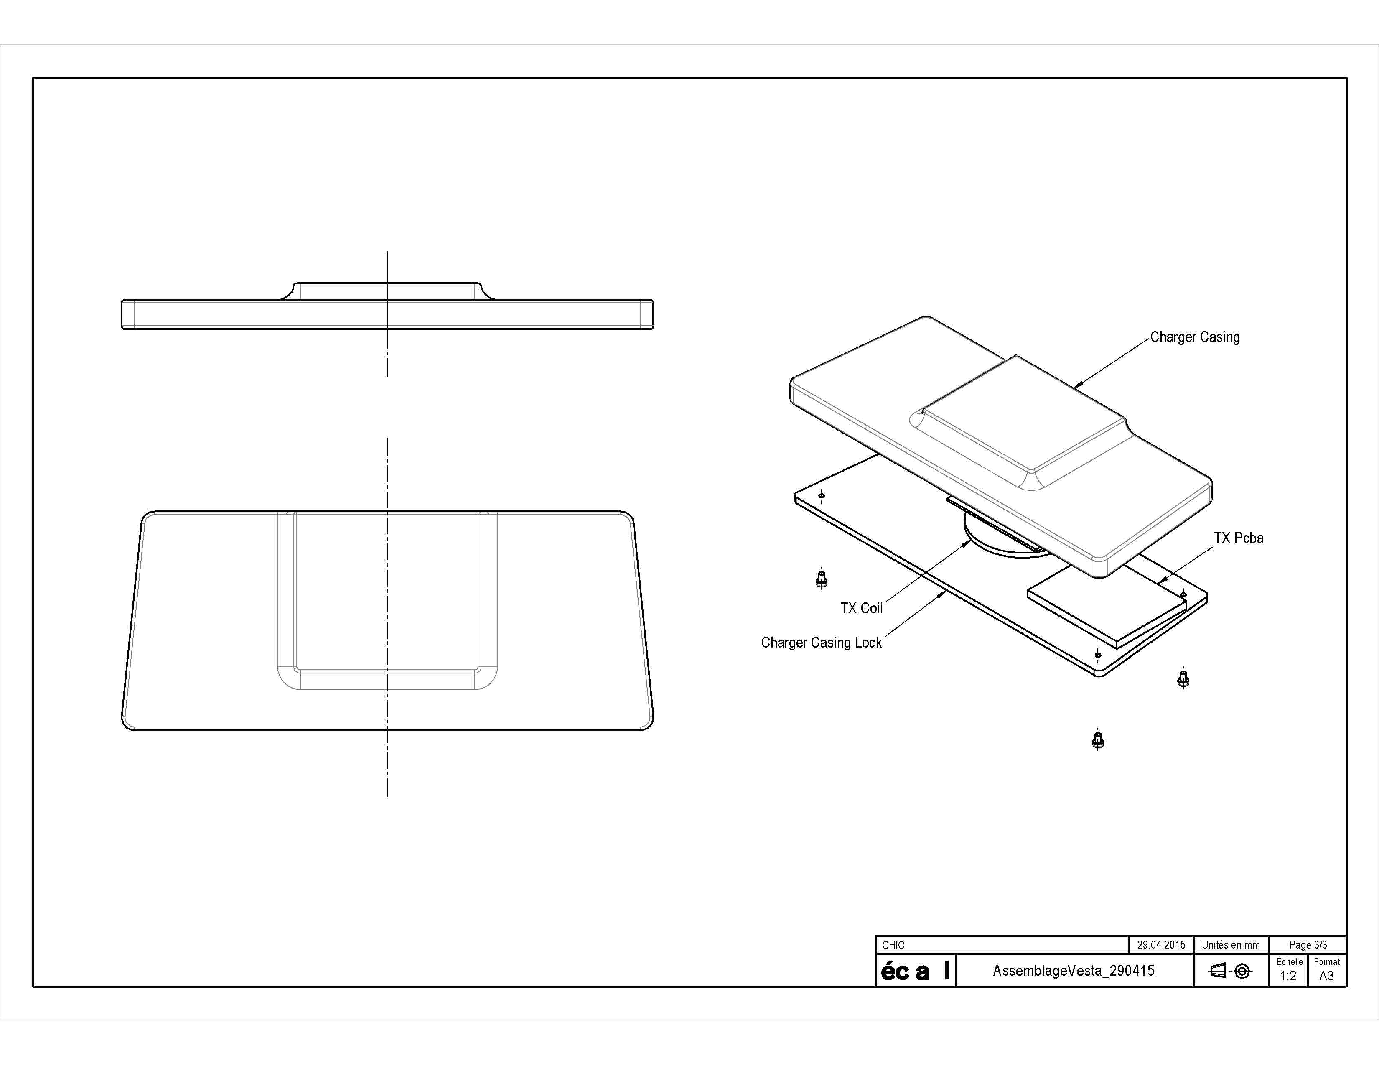
Rapports/vesta_latex_repport/chap/designFig/AssemblageVestaD_290415.JPG
