jbregnard/vesta/vesta_pcb_files/Vesta_cape.pdf

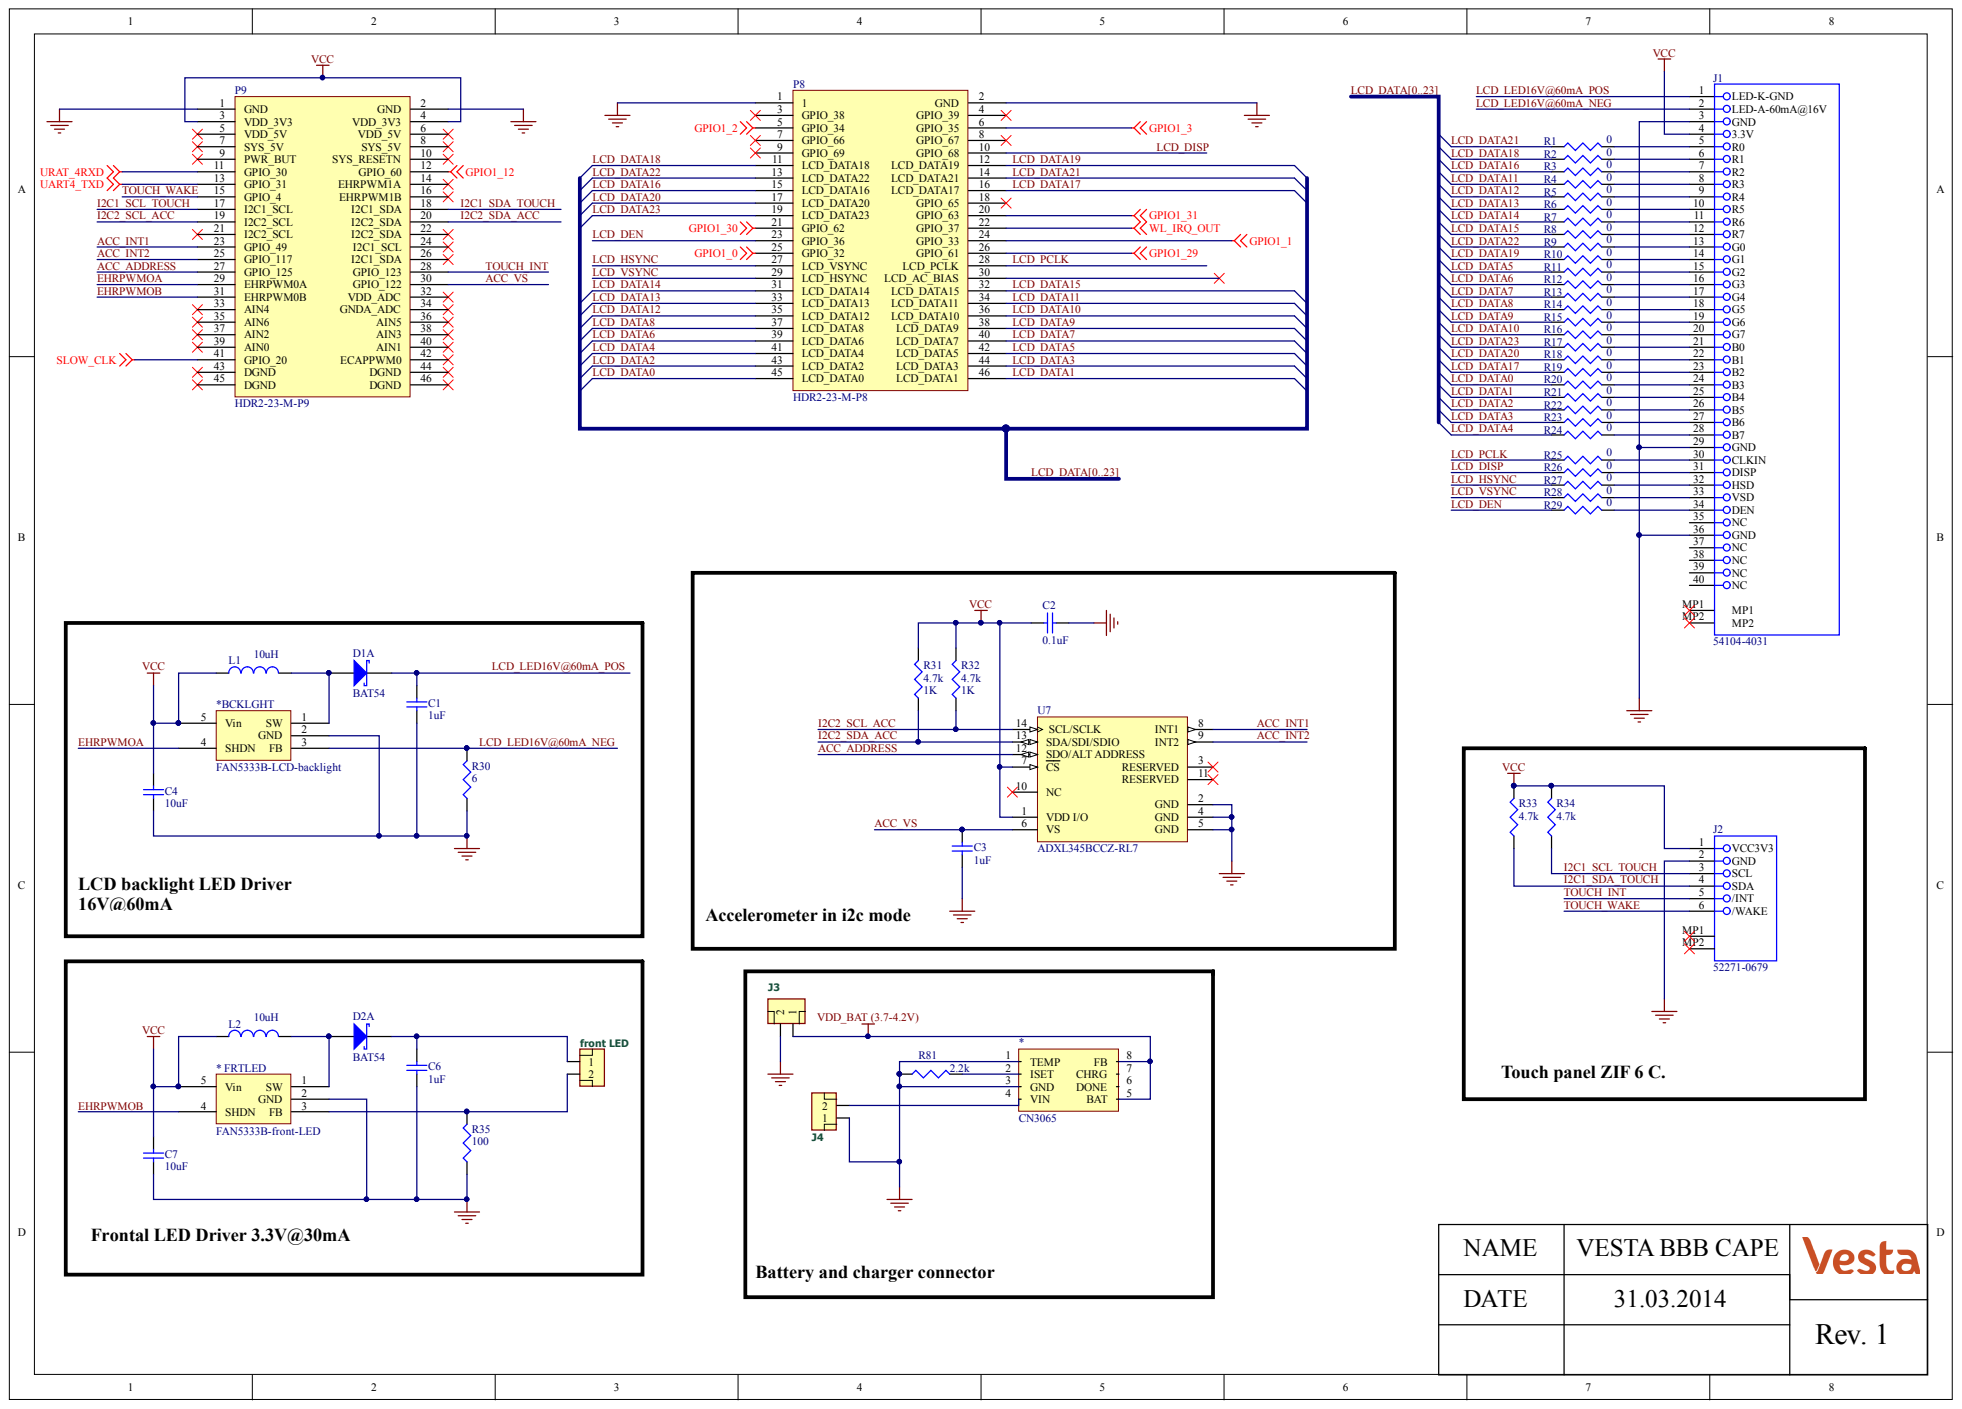
[picture p79: page 1]

3 | | 4 | GPI O1_12 | 6 8

GPI O1_2 7 9 ATA18 1 1 ATA22 | | 4 GPI O1_3 L C D_D ISP

Frontal L

NAME | VES TA BBB CAP E

tery and charger connector

DATE | 31.03.2014
