jbregnard/vesta/vesta_pcb_files/Vesta_cape_wifi.pdf

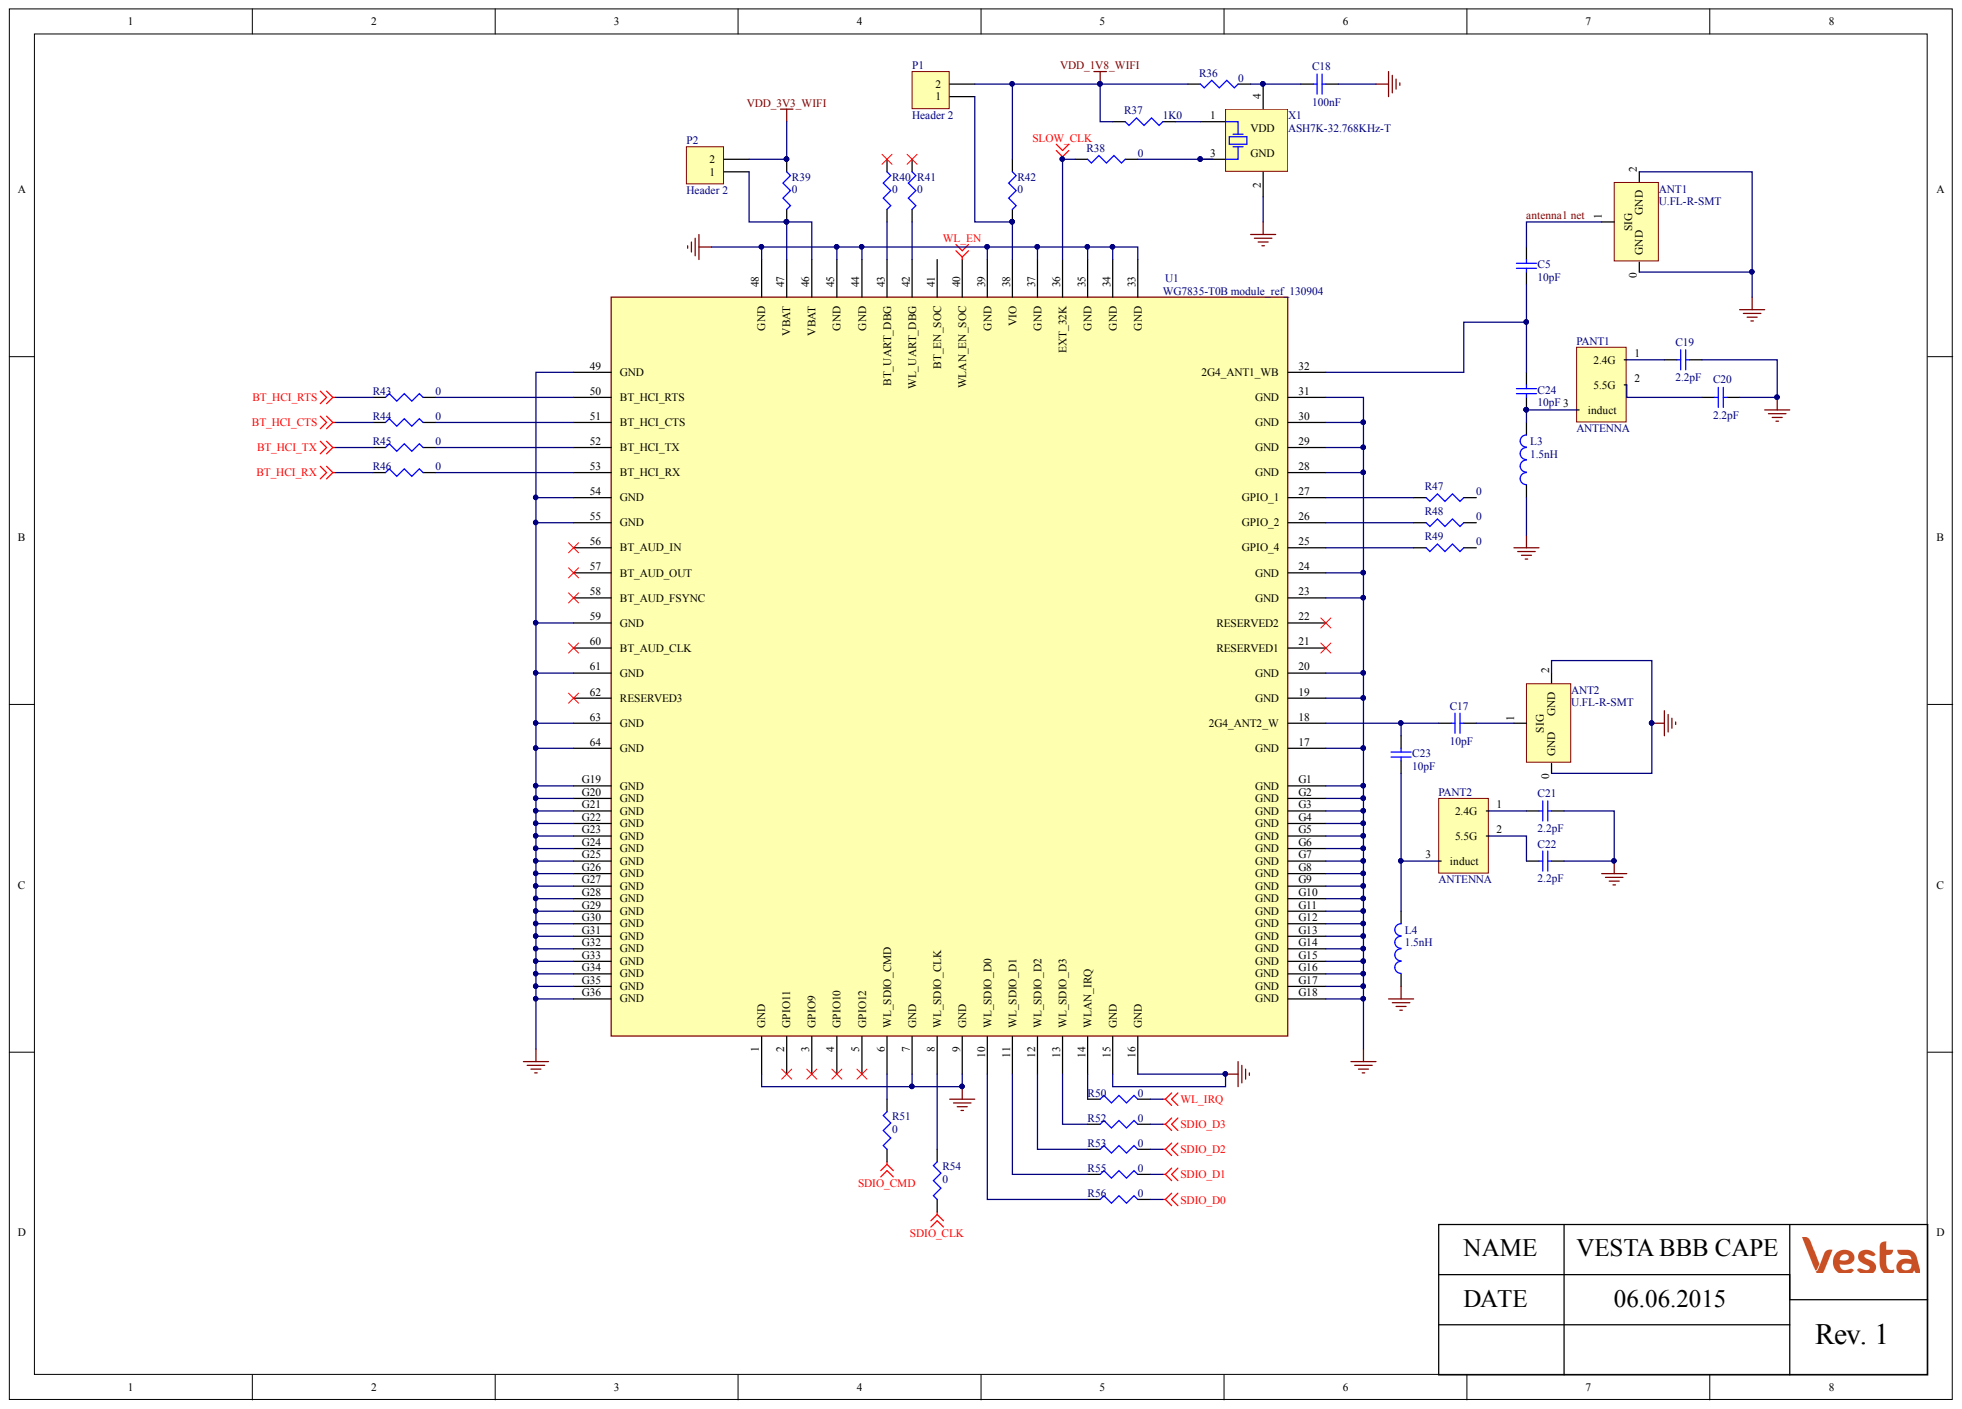
[picture p80: page 1]

BT_HCI_RTS 50 BT_HCI_CTS 51 BT_HCI_TX 52 BT_HCI_RX 53 GND 54

GND 55

GND 64

GND G19

NAME | VESTA BBB CAPE

DATE | 06.06.2015
