jbregnard/vesta/Vesta_cape.pdf

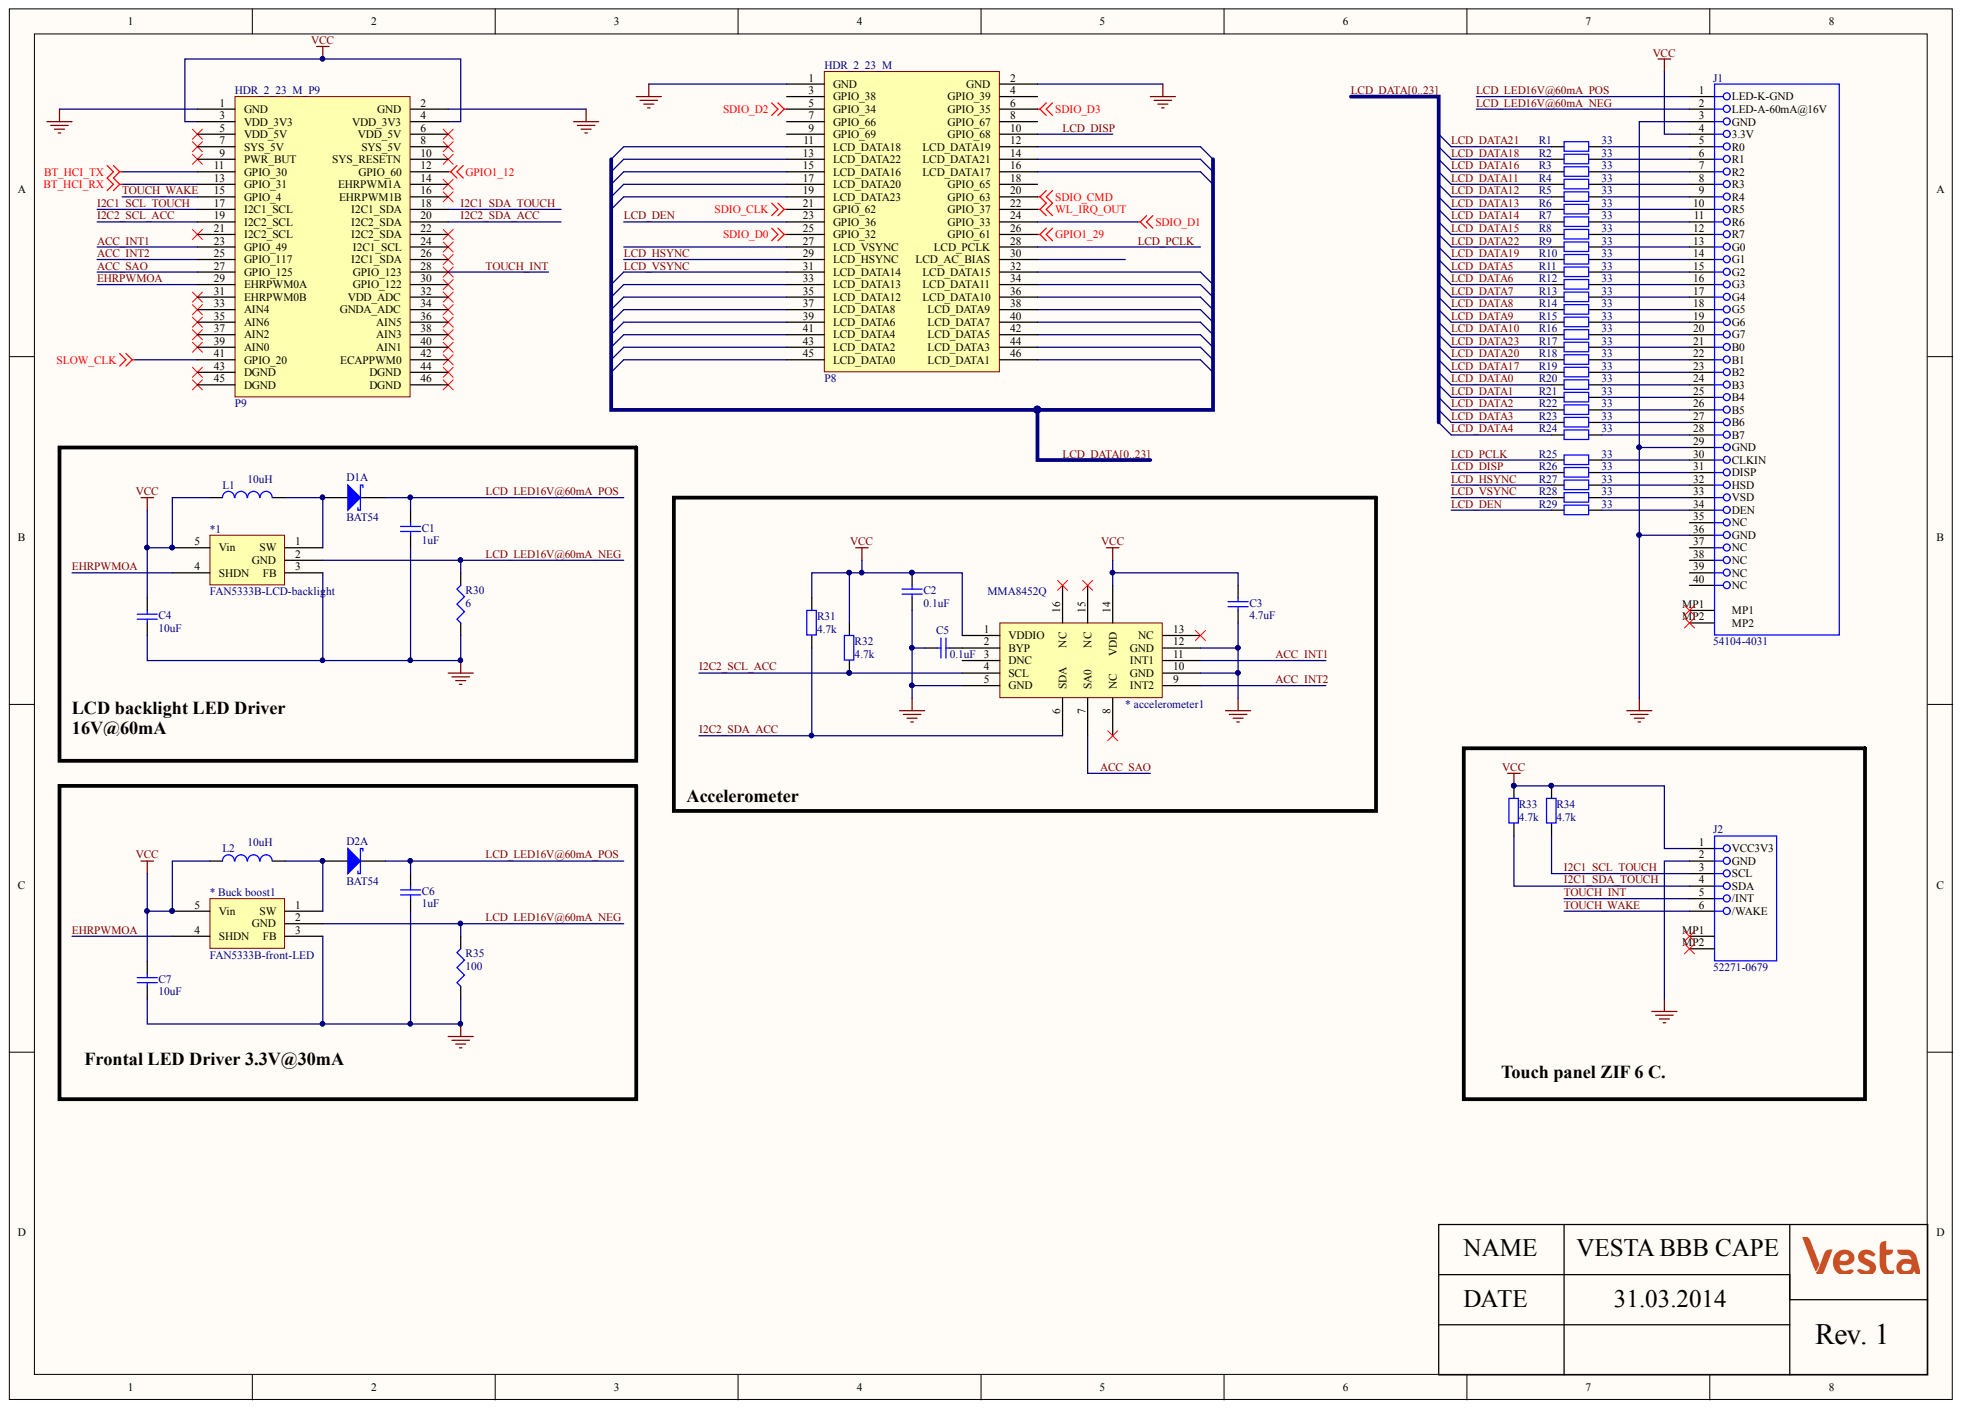
[picture p81: page 1]

NAME | VES TA BBB CAP E

DATE | 31.03.2014
