jbregnard/vesta/vesta_pcb_files/vesta_IO_buffering.pdf

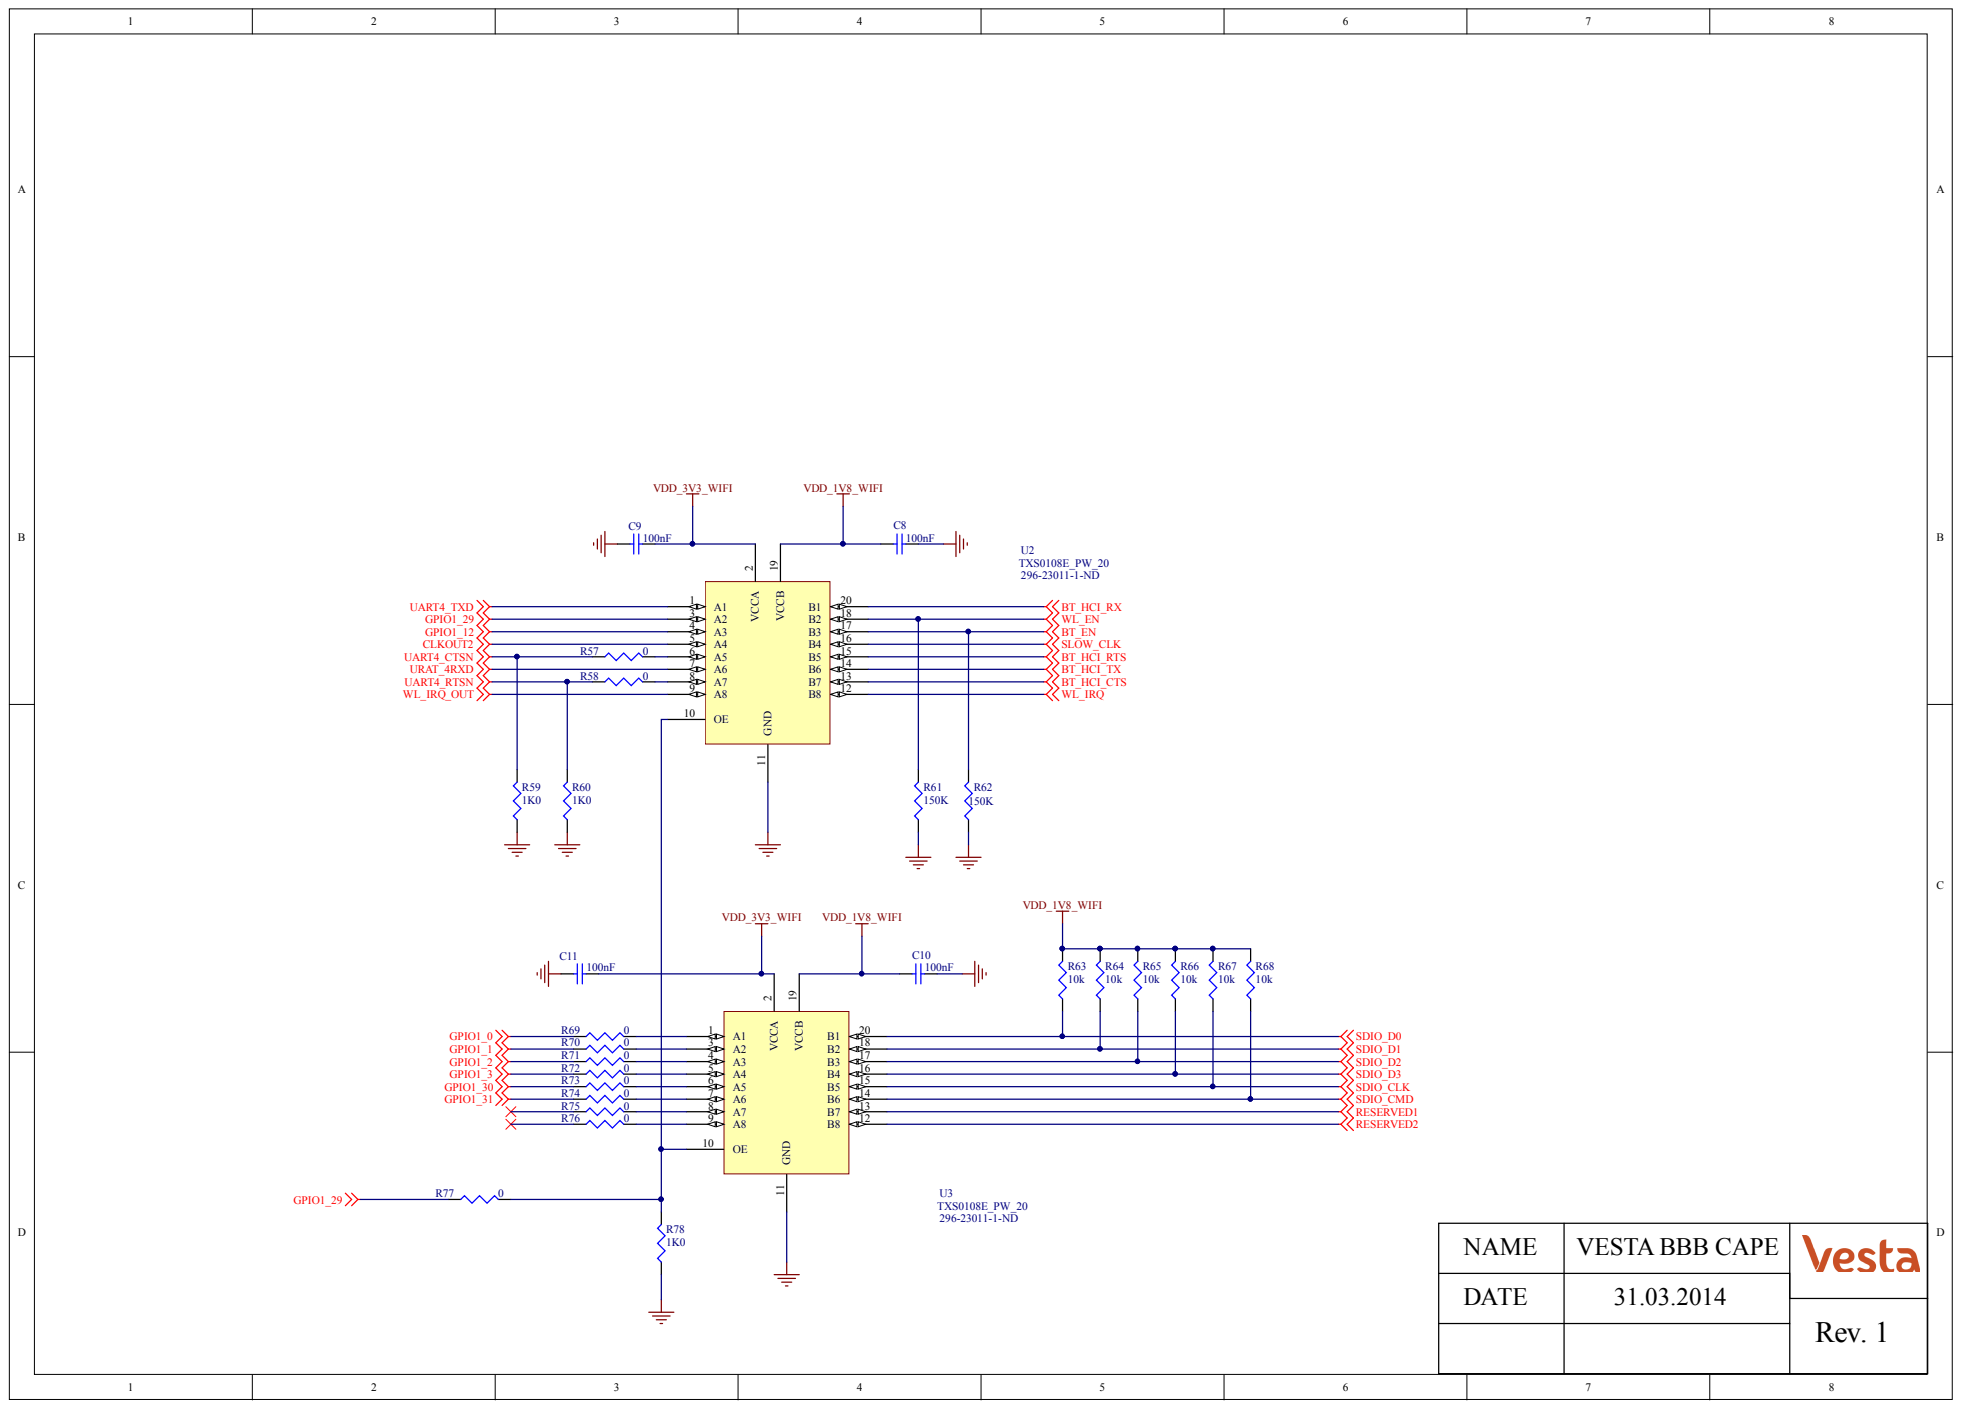
[picture p82: page 1]

NAME | VESTA BBB CAPE

DATE | 31.03.2014
