jbregnard/vesta/vesta_pcb_files/Vesta_wifi_power_3v3_1v8.pdf

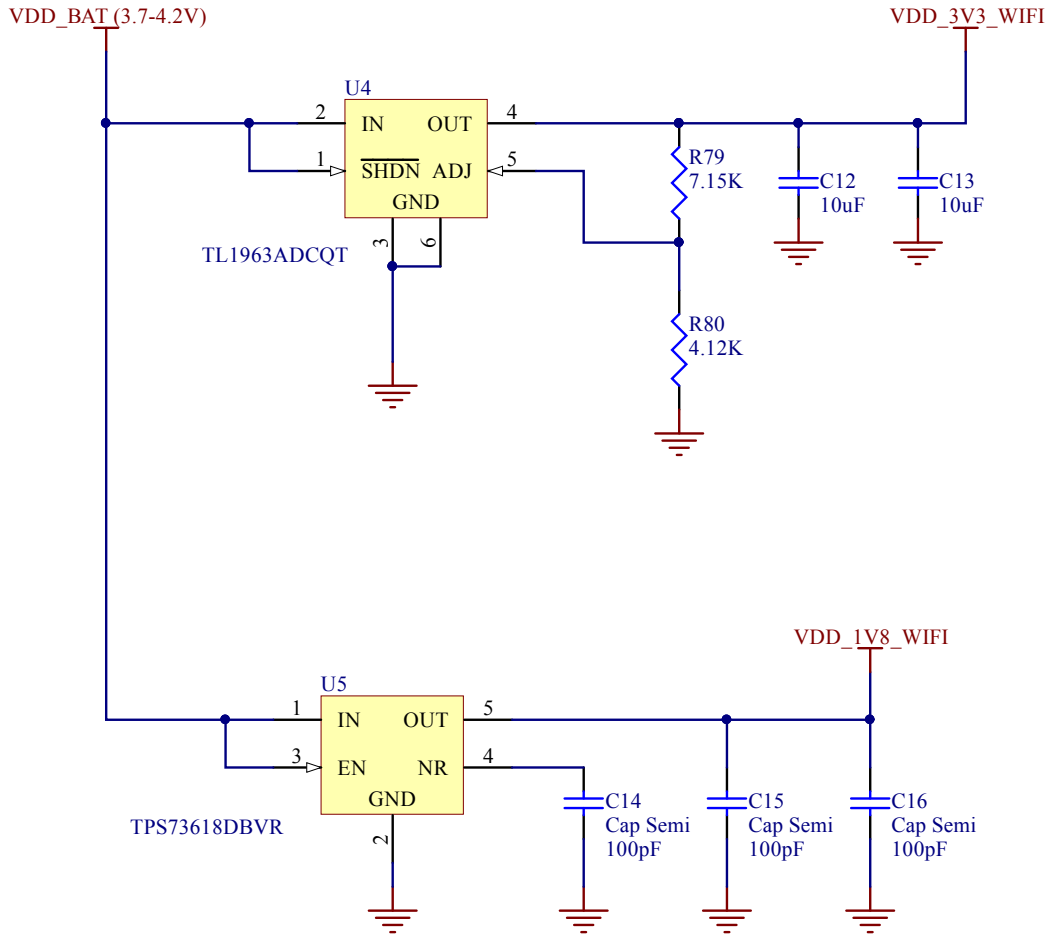
[picture p83: page 1]

NAME | VESTA BBB CAPE

DATE | 06.06.2015
