jbregnard/vesta/(list of files, drawings)

Other design files:
vesta_pcb_files/vesta.PcbLib
vesta_pcb_files/Vesta_cape.PcbDoc
vesta_pcb_files/Vesta_cape.PrjPcb
vesta_pcb_files/Vesta_cape.SchDoc
vesta_pcb_files/Vesta_cape.SchLib
vesta_pcb_files/Vesta_cape_wifi.SchDoc
vesta_pcb_files/vesta_IO_buffering.SchDoc
vesta_pcb_files/Vesta_wifi_power_3v3_1v8.SchDoc
vesta_pcb_files/VestaTop.SchDoc
