jbregnard/vesta/(commit log)

2015-05-07 all pcb files
    [VestaTop.SchDoc, Vesta_cape.PrjPcb, Vesta_cape.SchLib, Vesta_cape_wifi.SchDoc, Vesta_wifi_power_3v3_1v8.SchDoc, vesta_IO_buffering.SchDoc]
2015-05-07 Add of the design part of the project
    [Battery.SLDPRT, BeaglboneSimple.SLDPRT, Charger.sldprt, ChargerClip.sldprt, Coque.SLDPRT, Dualock3M.SLDPRT, Frame.sldprt, Led.SLDPRT]
2015-05-07 pcb update
    [Vesta_cape.PcbDoc, Vesta_cape.PrjPcb, Vesta_cape.SchLib, Vesta_cape_wifi.SchDoc, vesta.PcbLib]
2015-05-08 PCB version 1
    [Vesta_cape.PcbDoc, Vesta_cape.SchDoc]
2015-05-08 pcb step file
2015-06-04 question design pcb
2015-06-04 pcb update and schematics pdf
    [Vesta_cape.PcbDoc, Vesta_cape.SchDoc, vesta.PcbLib]
2015-06-07 pcb step file update
2015-06-14 documents update including BOM
    [PCB Parameter V1..xlsx, VESTA_PCB_Parameters.xlsx, Vesta_BOM.xlsx, vesta_bom_10_06_2015.xls, 【Template】Seeed BOM Format.xlsx]
